mhollands/EOGee/EOGee1/Circuit_Analysis/Noise_Measurements/IMG_5777.JPG

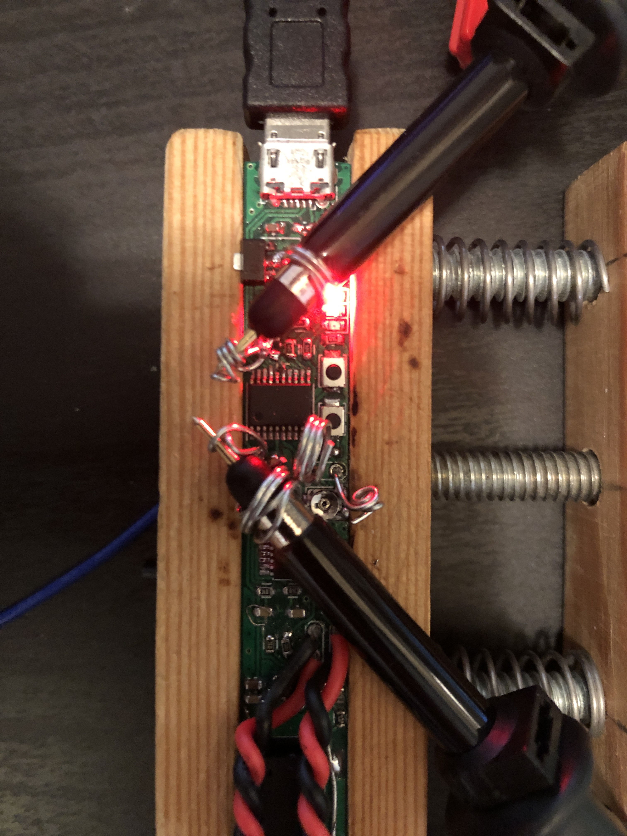
EOGee1/Circuit_Analysis/Noise_Measurements/IMG_5777.JPG
