mhollands/EOGee/README.md

# EOGee
PCB and code for capturing electrooculograms (EOG).
