mhollands/EOGee/EOGee1/Circuit_Analysis/Scope_Shots/AC_Couple/SCR09.PNG

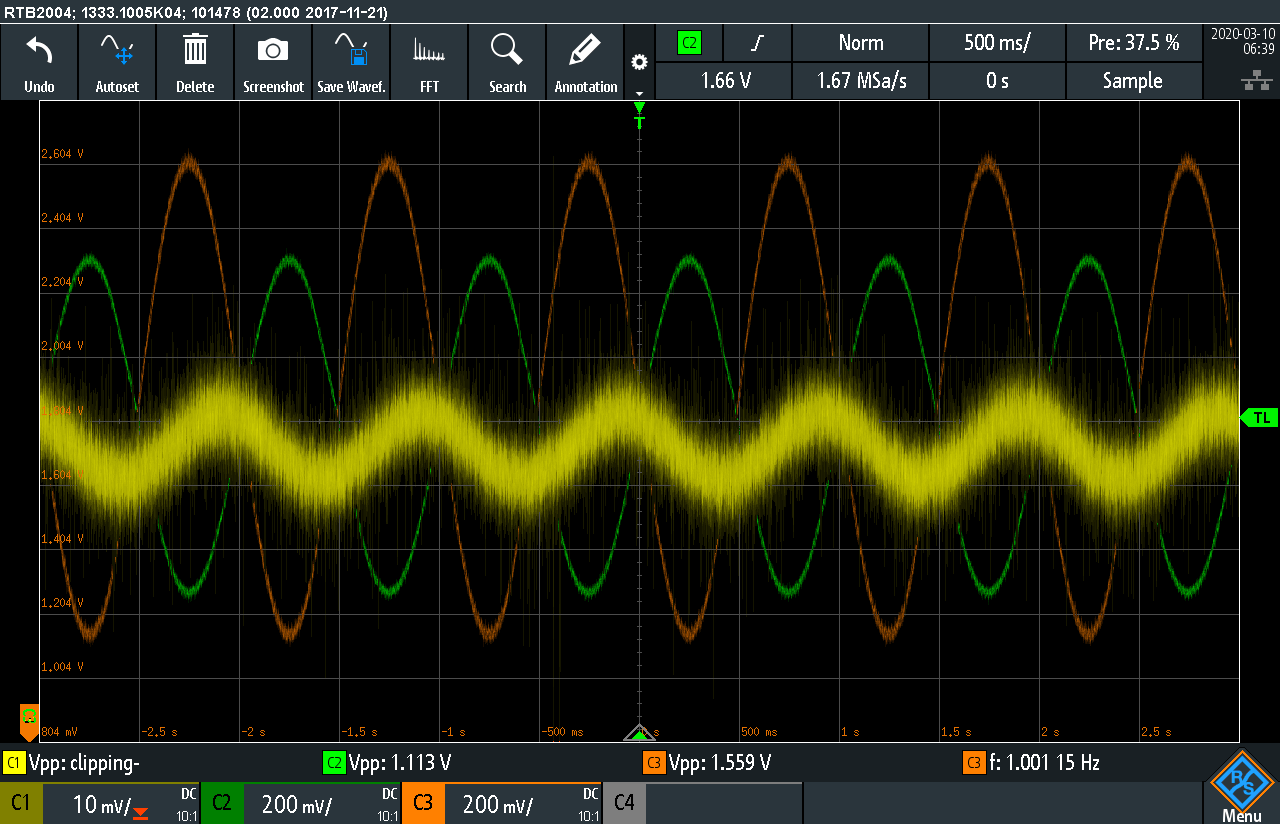
EOGee1/Circuit_Analysis/Scope_Shots/AC_Couple/SCR09.PNG
