mhollands/EOGee/Models/Glasses/EOGlass1/Media/back_view.png

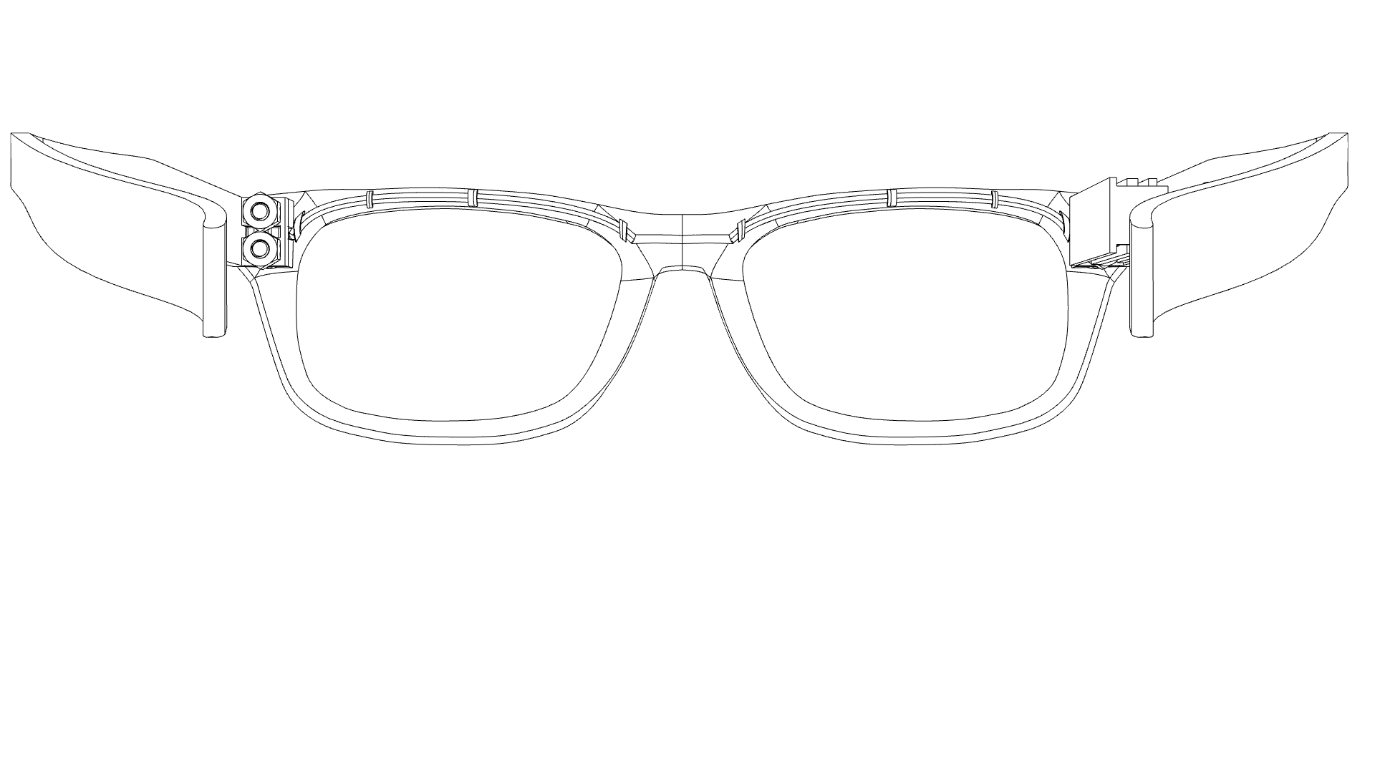
Models/Glasses/EOGlass1/Media/back_view.png
