mhollands/EOGee/Models/Glasses/EOGlass1/Media/Front_view.png

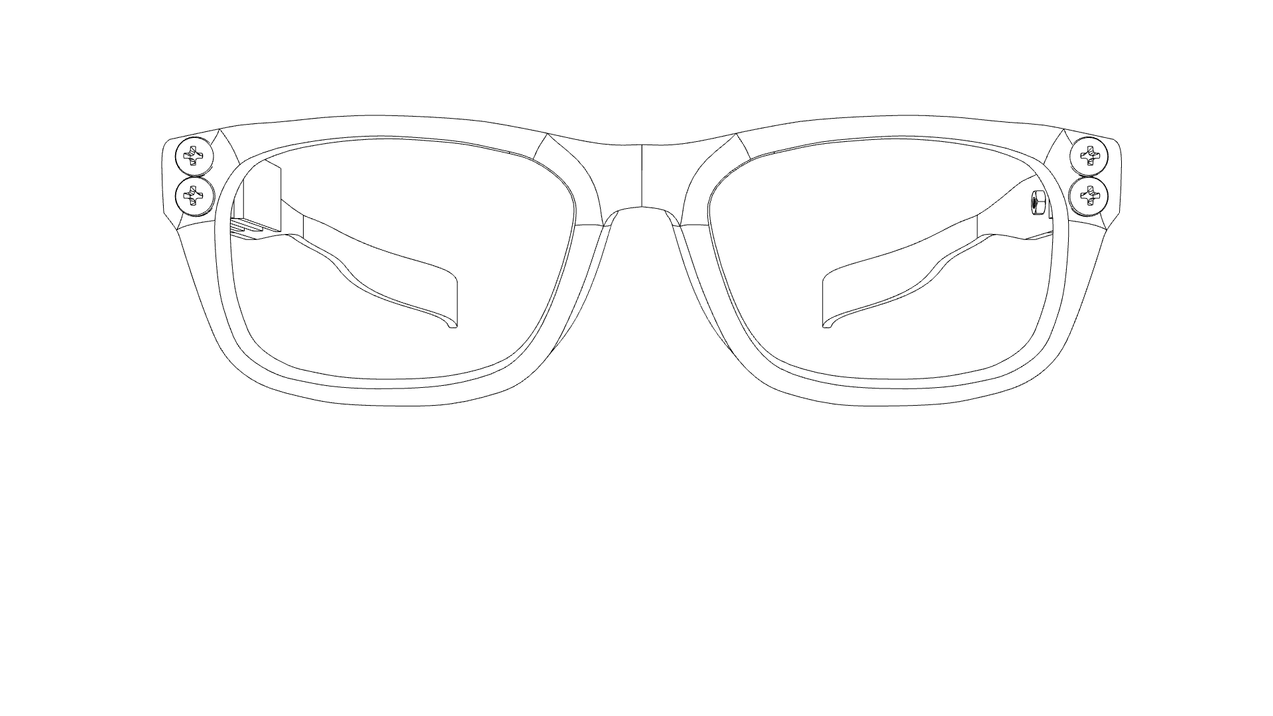
Models/Glasses/EOGlass1/Media/Front_view.png
