mhollands/EOGee/Models/Glasses/EOGlass1/Media/home_view.png

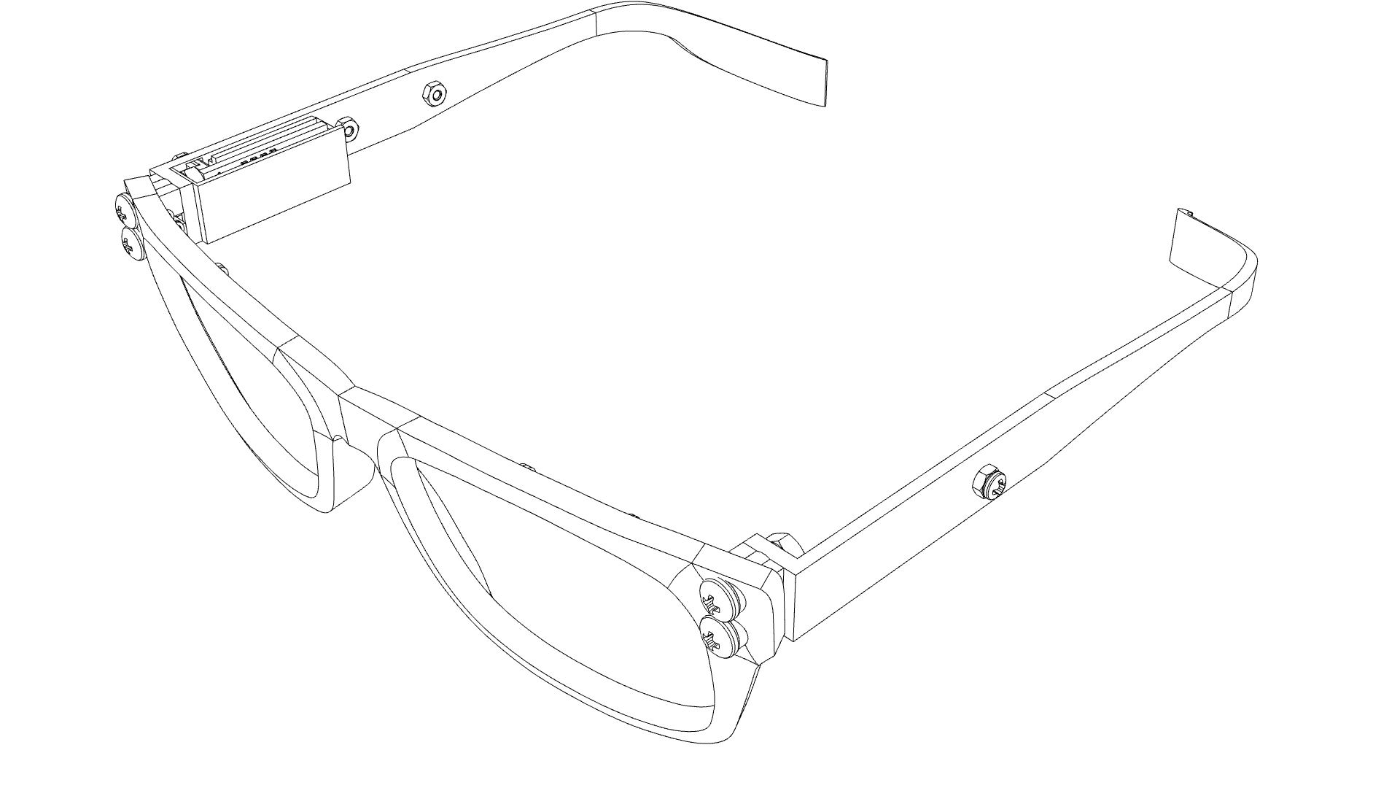
Models/Glasses/EOGlass1/Media/home_view.png
