mhollands/EOGee/Models/Glasses/EOGlass1/Media/LeftArmExploded.png

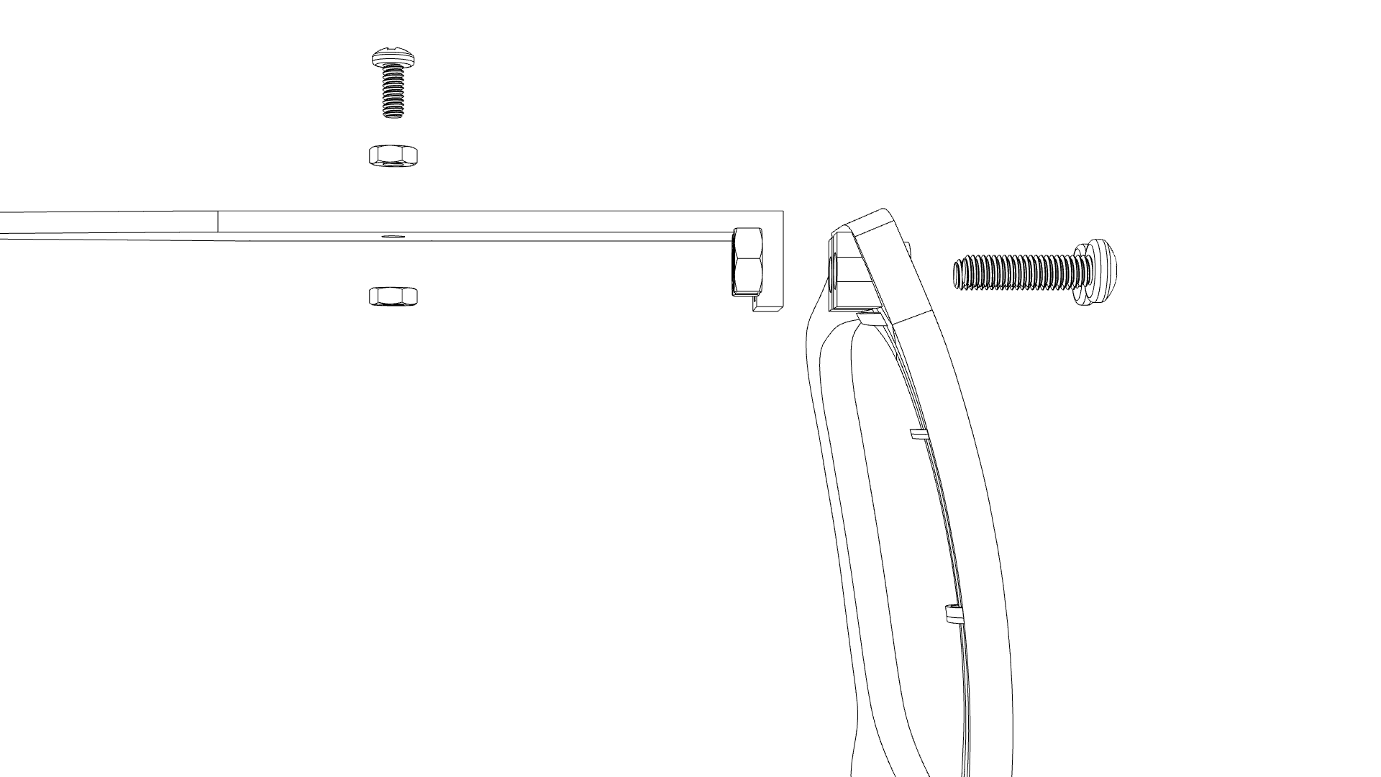
Models/Glasses/EOGlass1/Media/LeftArmExploded.png
