mhollands/EOGee/Models/Glasses/EOGlass1/Media/render 2.GIF

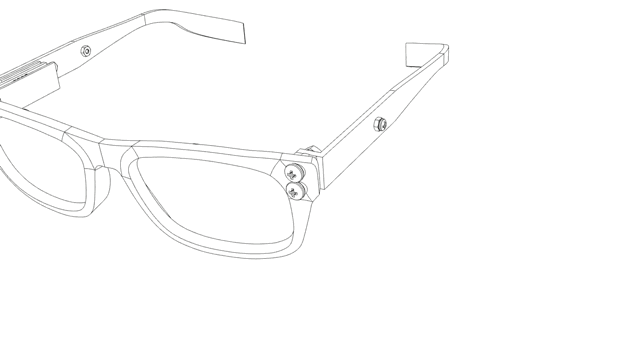
Models/Glasses/EOGlass1/Media/render 2.GIF
