mhollands/EOGee/Models/Glasses/EOGlass1/Media/render 3.GIF

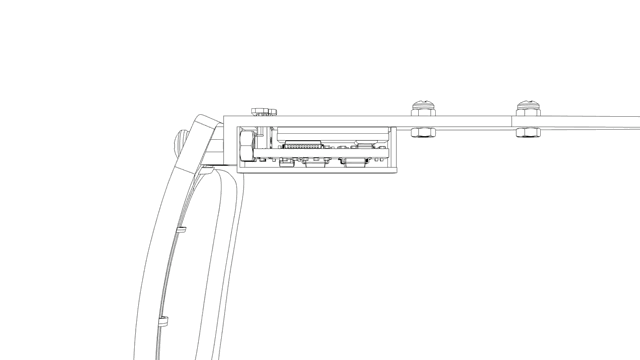
Models/Glasses/EOGlass1/Media/render 3.GIF
