mhollands/EOGee/Models/Glasses/EOGlass1/Media/render.GIF

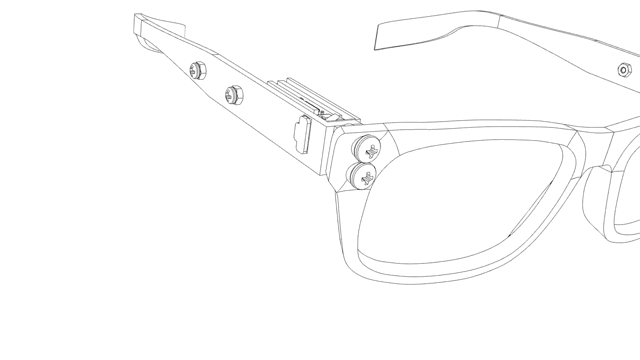
Models/Glasses/EOGlass1/Media/render.GIF
