mhollands/EOGee/Models/Glasses/EOGlass1/Media/Right_arm_exploded.png

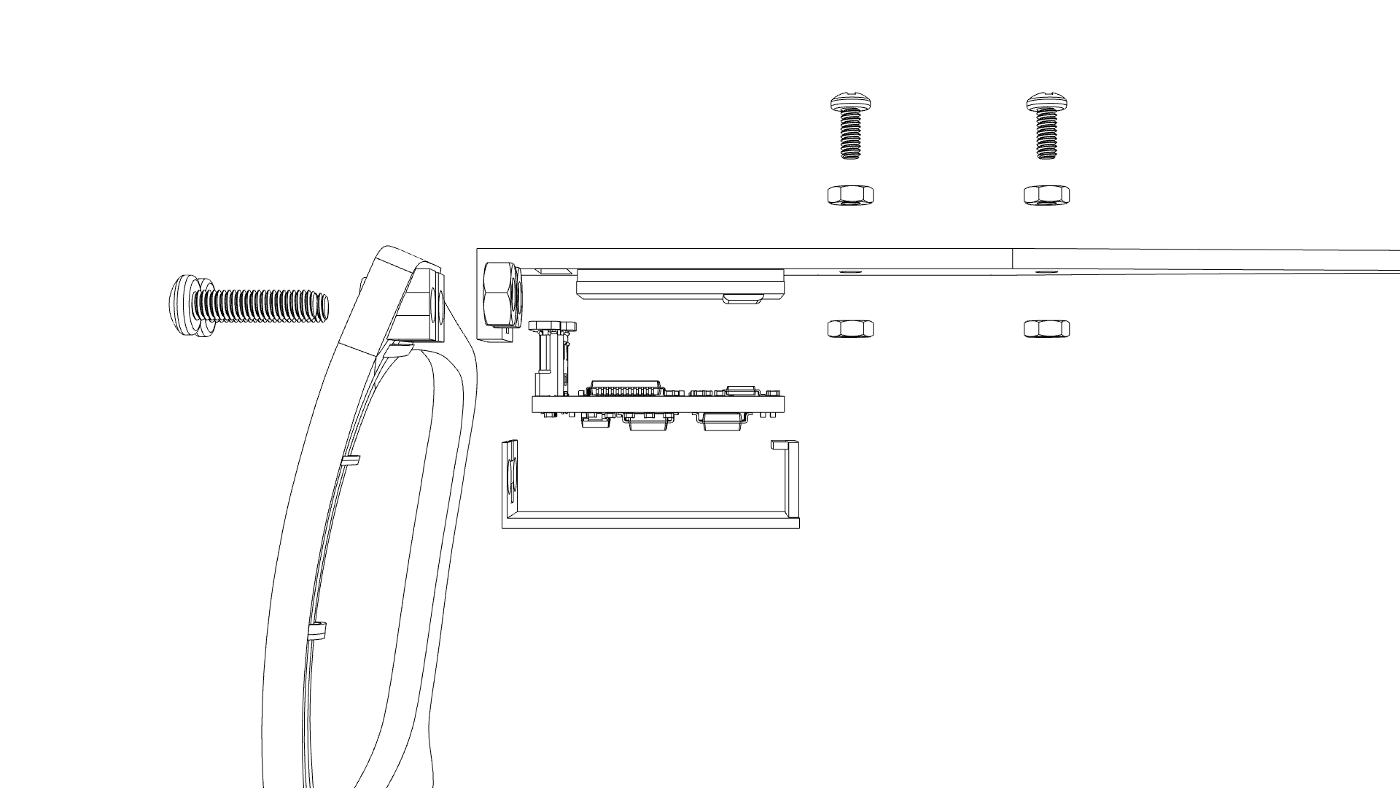
Models/Glasses/EOGlass1/Media/Right_arm_exploded.png
