mhollands/EOGee/Models/Glasses/EOGlass1/Media/Wire_channels.png

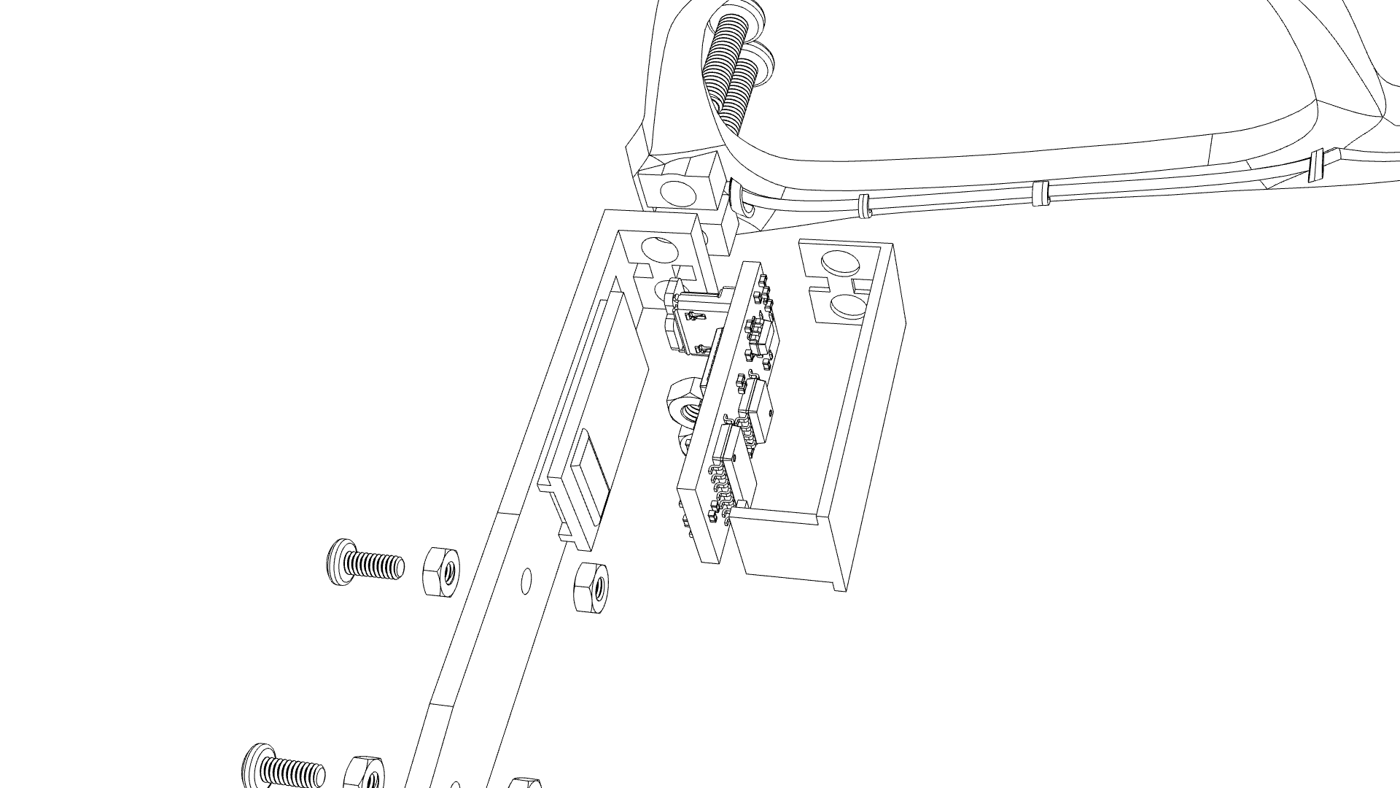
Models/Glasses/EOGlass1/Media/Wire_channels.png
