mhollands/EOGee/EOGee2/Models/clip.stl

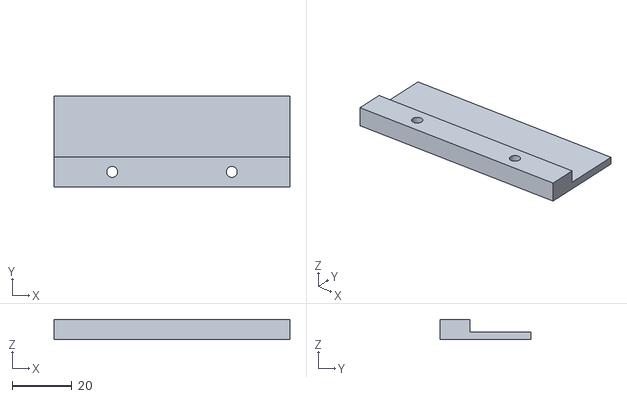
[picture p16: CAD file, 2020-05-25]
EOGee2/Models/clip.stl
79.0 x 30.4 x 6.70
