mhollands/EOGee/EOGlass1/EOGlass v1.stl

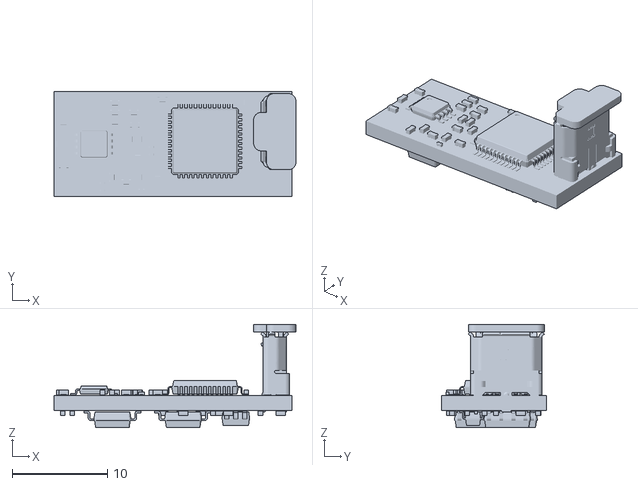
[picture p17: CAD file, 2020-06-01]
EOGlass1/EOGlass v1.stl
25.4 x 11.0 x 10.9
