mhollands/EOGee/EOGlass1/Models/arm2_contact_hooked_right2 v6.stl

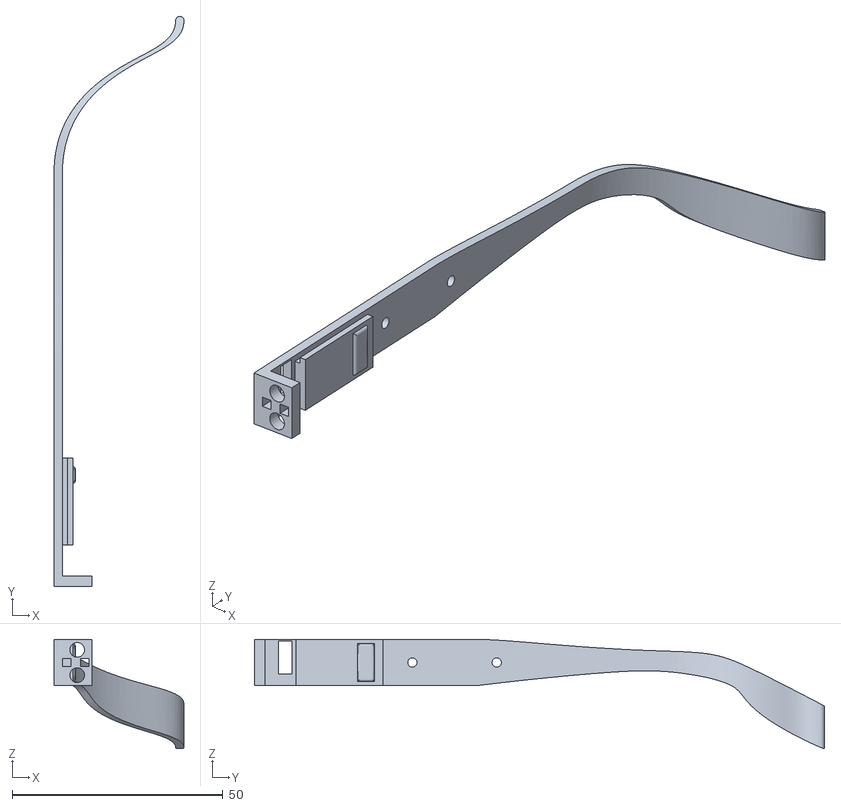
[picture p18: CAD file, 2020-06-01]
EOGlass1/Models/arm2_contact_hooked_right2 v6.stl
30.8 x 135.3 x 25.9
