mhollands/EOGee/Models/Glasses/OpenSCAD/Plastic_snap.stl

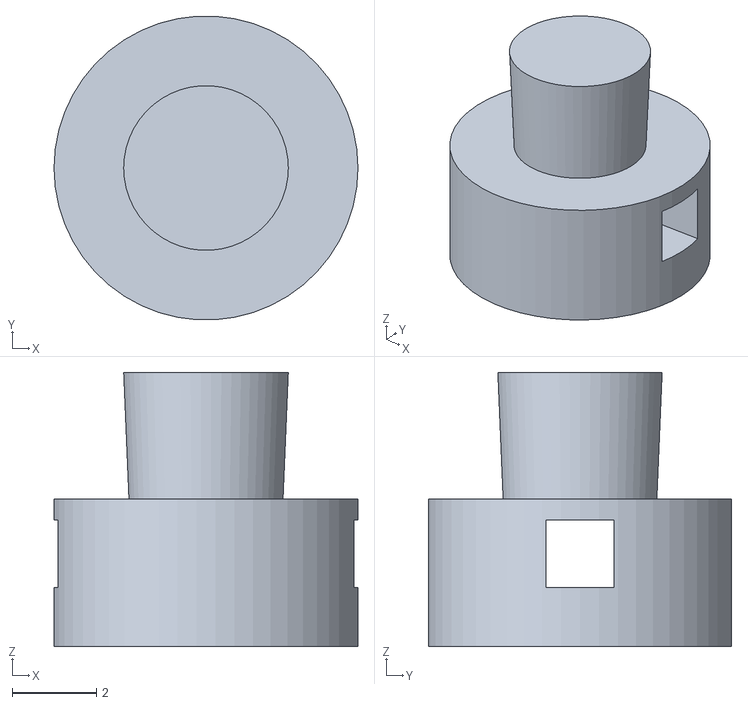
[picture p19: CAD file, 2020-03-28]
Models/Glasses/OpenSCAD/Plastic_snap.stl
7.20 x 7.19 x 6.50
