mhollands/EOGee/SigGenAdapter/Housing/Base.stl

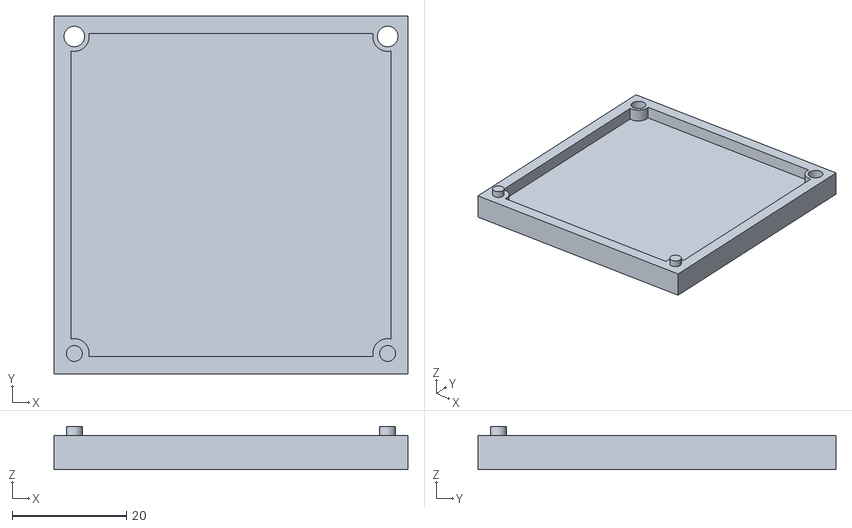
[picture p20: CAD file, 2020-03-22]
SigGenAdapter/Housing/Base.stl
62.0 x 62.6 x 7.60
