mhollands/EOGee/EOGee2/Models/Base_clip.stl

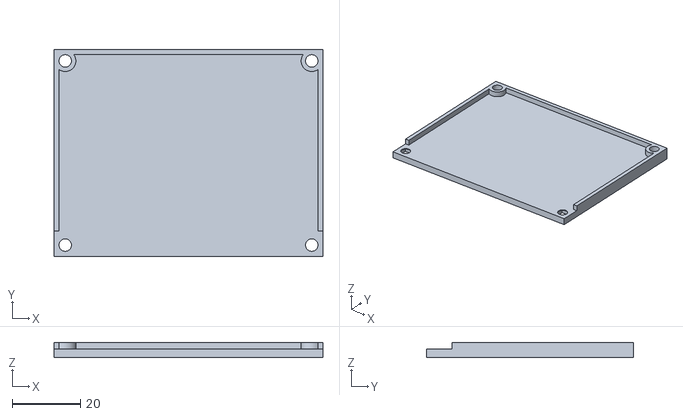
[picture p21: CAD file, 2020-05-25]
EOGee2/Models/Base_clip.stl
79.0 x 60.7 x 4.50
