mhollands/EOGee/EOGlass1/Models/PCB_Cover v12.stl

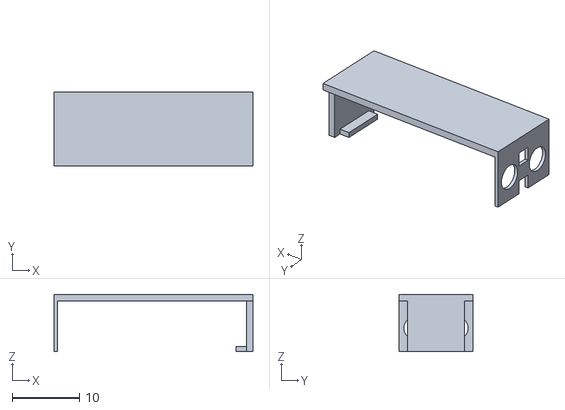
[picture p22: CAD file, 2020-06-01]
EOGlass1/Models/PCB_Cover v12.stl
29.5 x 11.0 x 8.50
