mhollands/EOGee/Models/Glasses/OpenSCAD/Glasses_front.stl

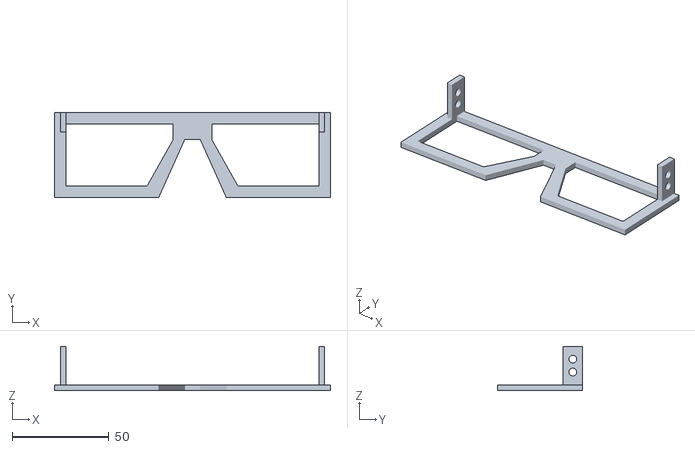
[picture p23: CAD file, 2020-02-24]
Models/Glasses/OpenSCAD/Glasses_front.stl
143.0 x 44.0 x 23.0
