mhollands/EOGee/SigGenAdapter/Housing/Lid.stl

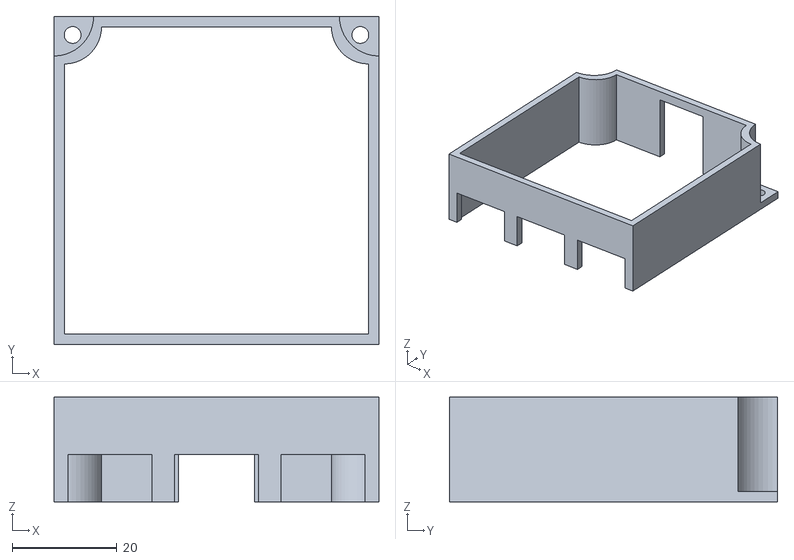
[picture p24: CAD file, 2020-03-22]
SigGenAdapter/Housing/Lid.stl
62.0 x 62.6 x 20.0
