mhollands/EOGee/EOGee2/Models/Base.stl

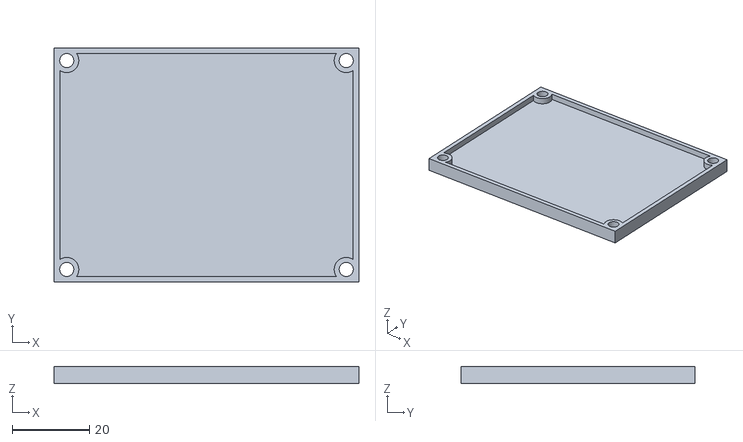
[picture p25: CAD file, 2020-04-12]
EOGee2/Models/Base.stl
79.0 x 60.7 x 4.50
