mhollands/EOGee/EOGlass1/Models/arm2_contact_hooked_LEFT v2.stl

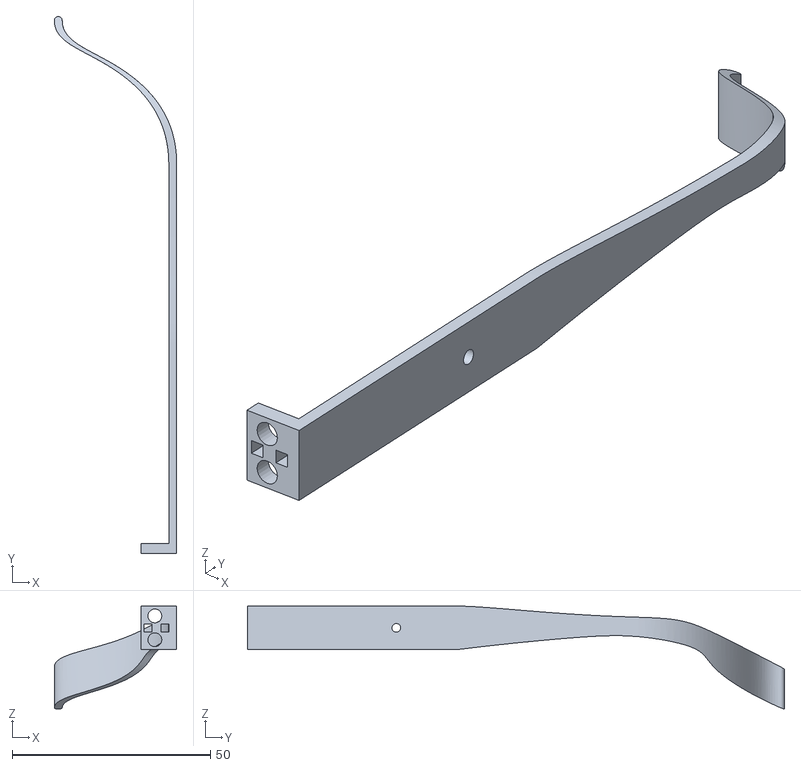
[picture p26: CAD file, 2020-06-01]
EOGlass1/Models/arm2_contact_hooked_LEFT v2.stl
30.8 x 135.3 x 25.9
