mhollands/EOGee/Models/Glasses/OpenSCAD/Glasses_front_right.stl

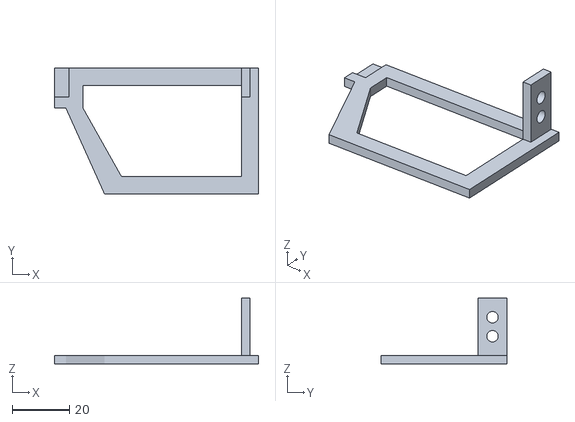
[picture p27: CAD file, 2020-02-24]
Models/Glasses/OpenSCAD/Glasses_front_right.stl
71.5 x 44.0 x 23.0
