mhollands/EOGee/EOGee2/Models/Housing.stl

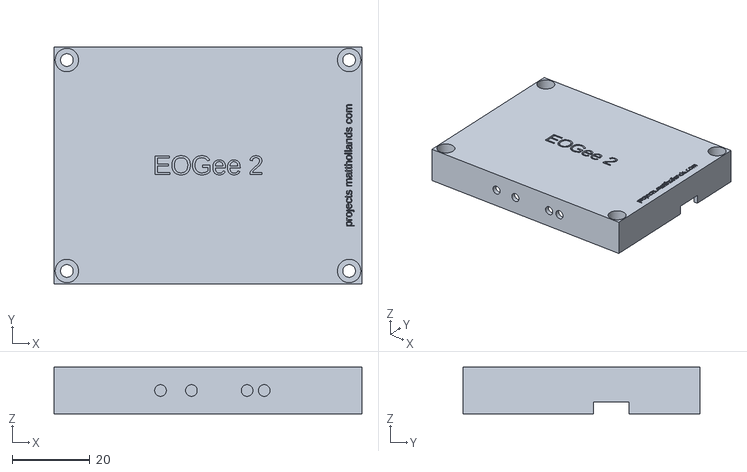
[picture p28: CAD file, 2020-04-12]
EOGee2/Models/Housing.stl
79.0 x 60.7 x 12.0
