mhollands/EOGee/EOGlass1/Models/Glasses2_integrated v3.stl

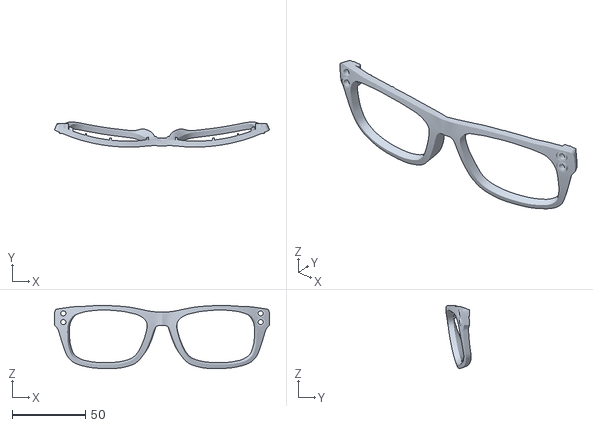
[picture p29: CAD file, 2020-06-01]
EOGlass1/Models/Glasses2_integrated v3.stl
146.9 x 17.2 x 43.1
