mhollands/EOGee/(list of files, cad)

Other CAD files:
EOGee2/Models/Base_clip.scad
