mhollands/EOGee/EOGee1/Circuit_Analysis/Noise_Measurements/Data_streamed_over_spi_no_usb/BUS05.CSV

Bus Table: B1 (SPI (no CS): 8 Bit, MSB, Clk = C1, Data = C2)
Frame | Mark | Time Diff. in s | Length | Data | State
1 |  | 12.52844800e-3 | 20 | 0xB407B507B507B407B407B407B407B307B407B407 | OK
2 |  | 13.65203200e-3 | 20 | 0xB307B307B407B407B407B307B507B407B407B307 | OK
3 |  | 13.65324800e-3 | 20 | 0xB407B507B407B507B307B407B507B407B407B307 | OK
4 |  | 13.65324800e-3 | 20 | 0xB407B407B407B307B407B407B407B307B407B407 | OK
5 |  | 13.65203200e-3 | 20 | 0xB407B307B307B407B407B507B407B407B407B407 | OK
6 |  | 13.65446400e-3 | 20 | 0xB407B407B407B407B407B307B407B407B507B407 | OK
7 |  | 13.65324800e-3 | 20 | 0xB307B407B307B407B407B407B407B307B407B307 | OK
8 |  | 13.65324800e-3 | 20 | 0xB407B307B407B407B207B407B407B507B407B407 | OK
9 |  | 13.65203200e-3 | 20 | 0xB407B407B407B407B407B407B407B407B307B507 | OK
10 |  | 13.65324800e-3 | 20 | 0xB407B207B407B207B407B507B507B507B407B307 | OK
11 |  | 13.65081600e-3 | 20 | 0xB407B407B407B407B407B407B307B307B407B507 | OK
12 |  | 13.65324800e-3 | 20 | 0xB407B407B307B407B307B407B307B407B407B407 | OK
13 |  | 13.65324800e-3 | 20 | 0xB307B407B407B307B407B407B407B207B407B407 | OK
14 |  | 13.65324800e-3 | 20 | 0xB307B307B307B307B307B307B407B507B407B307 | OK
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
