mhollands/EOGee/EOGee1/Circuit_Analysis/Noise_Measurements/Data_streamed_over_spi_no_usb/BUS06.CSV

Bus Table: B1 (SPI (no CS): 8 Bit, MSB, Clk = C1, Data = C2)
Frame | Mark | Time Diff. in s | Length | Data | State
1 |  | 12.50169600e-3 | 20 | 0xB307B407B307B307B407B307B407B507B407B407 | OK
2 |  | 13.65568000e-3 | 20 | 0xB307B407B307B407B407B307B307B407B307B407 | OK
3 |  | 13.65568000e-3 | 20 | 0xB407B407B307B307B407B407B407B407B307B307 | OK
4 |  | 13.65568000e-3 | 20 | 0xB407B307B507B207B507B207B307B407B307B407 | OK
5 |  | 13.65446400e-3 | 20 | 0xB407B407B407B507B307B407B407B407B407B407 | OK
6 |  | 13.65568000e-3 | 20 | 0xB307B307B307B407B207B407B307B307B307B307 | OK
7 |  | 13.65568000e-3 | 20 | 0xB407B407B307B407B307B307B407B407B407B407 | OK
8 |  | 13.65689600e-3 | 20 | 0xB407B307B407B507B407B507B307B407B407B307 | OK
9 |  | 13.65689600e-3 | 20 | 0xB307B307B407B307B307B507B407B407B307B407 | OK
10 |  | 13.65568000e-3 | 20 | 0xB207B407B307B307B307B407B407B307B407B407 | OK
11 |  | 13.65689600e-3 | 20 | 0xB307B307B407B407B407B307B307B407B307B407 | OK
12 |  | 13.65446400e-3 | 20 | 0xB407B407B407B207B507B407B407B307B207B407 | OK
13 |  | 13.65568000e-3 | 20 | 0xB407B207B407B307B307B407B407B407B407B307 | OK
14 |  | 13.65568000e-3 | 20 | 0xB207B407B207B307B407B407B207B307B307B407 | OK
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
