mhollands/EOGee/EOGee1/Circuit_Analysis/Noise_Measurements/ADC_GULP.PNG

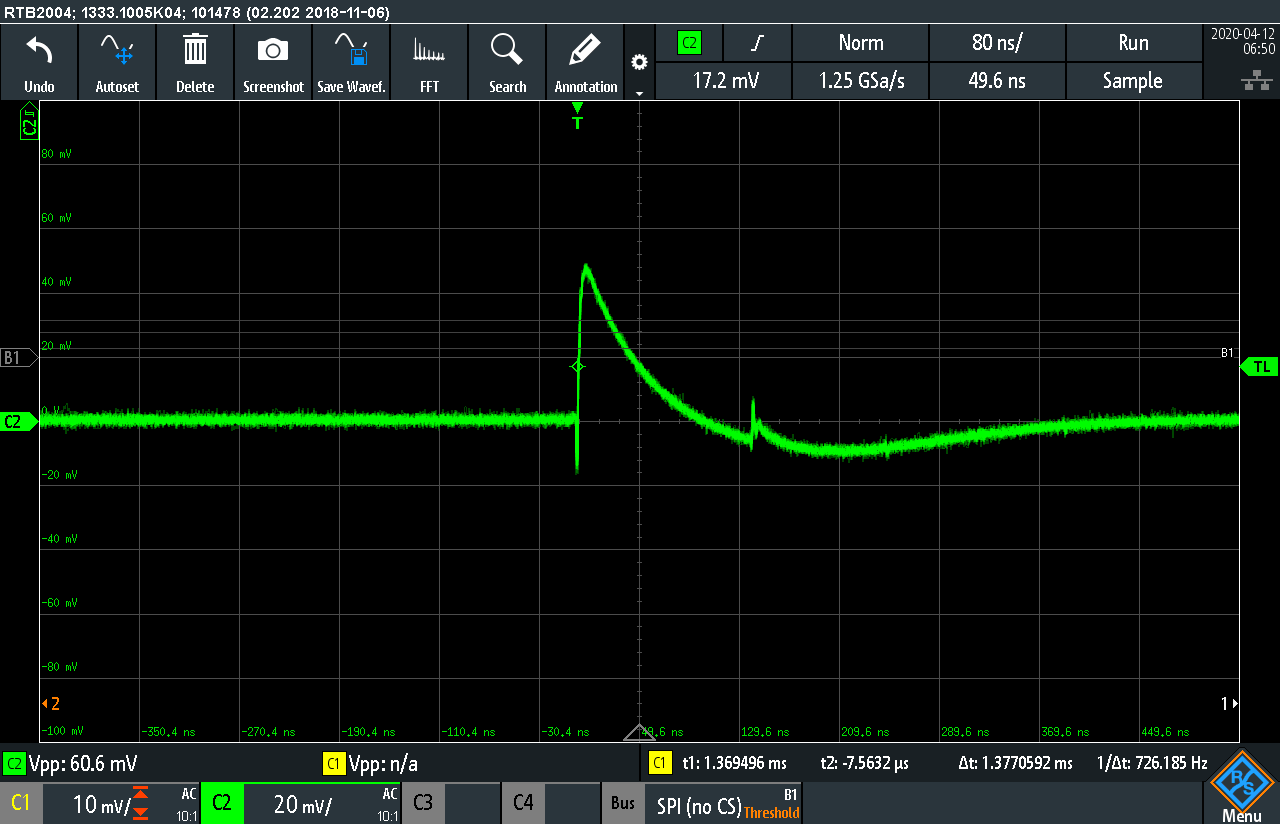
EOGee1/Circuit_Analysis/Noise_Measurements/ADC_GULP.PNG
