mhollands/EOGee/EOGee1/Circuit_Analysis/Noise_Measurements/AVDD_USB_OFF.PNG

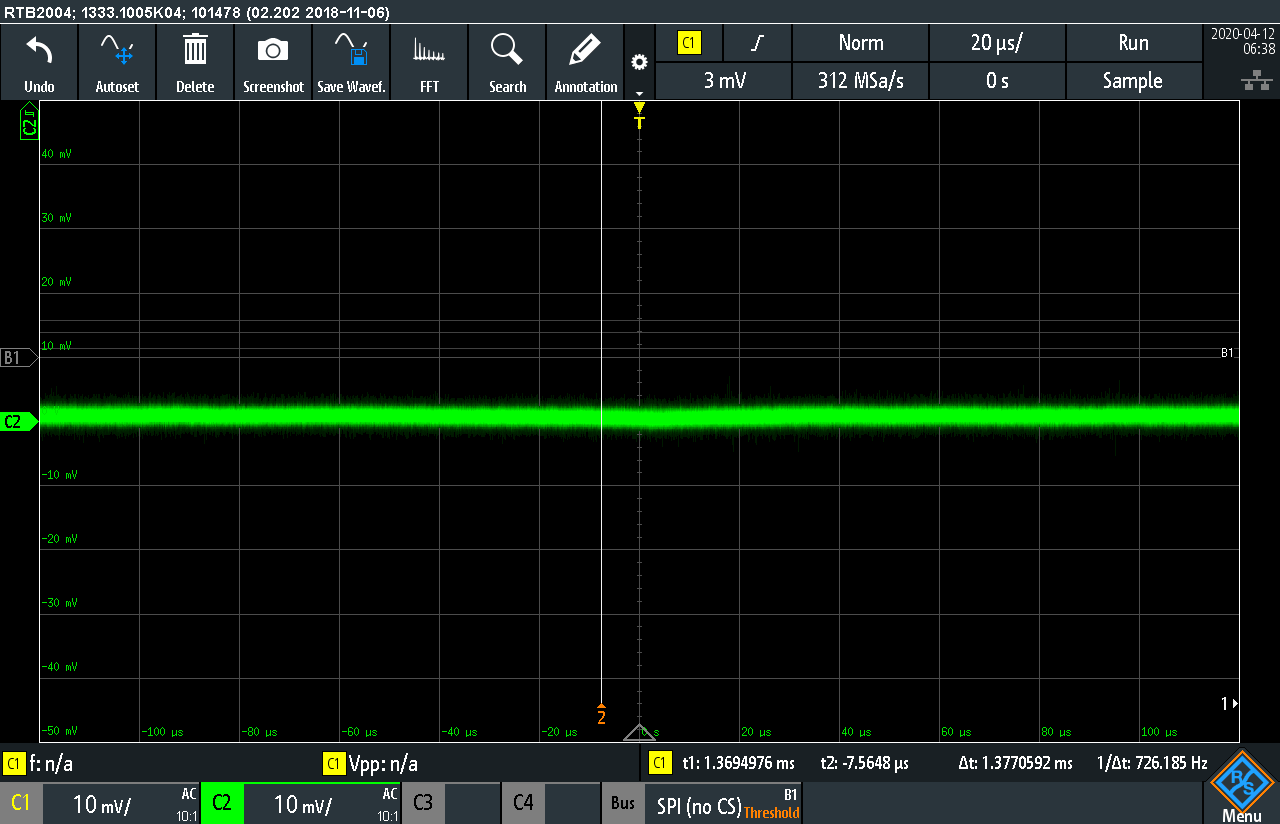
EOGee1/Circuit_Analysis/Noise_Measurements/AVDD_USB_OFF.PNG
