mhollands/EOGee/EOGee1/Circuit_Analysis/Noise_Measurements/AVDD_USB_ON.PNG

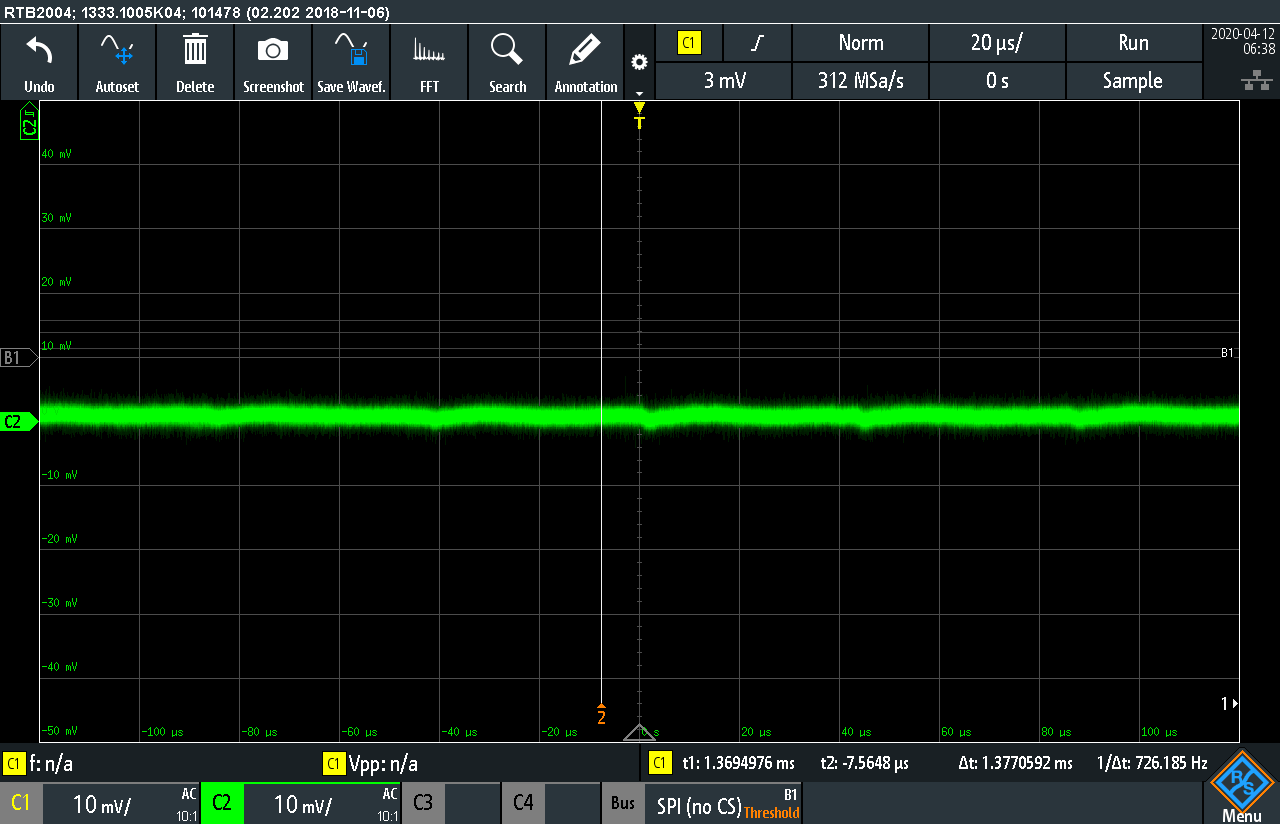
EOGee1/Circuit_Analysis/Noise_Measurements/AVDD_USB_ON.PNG
