mhollands/EOGee/EOGee1/Circuit_Analysis/Noise_Measurements/Data_streamed_over_spi_no_usb/SCR48.PNG

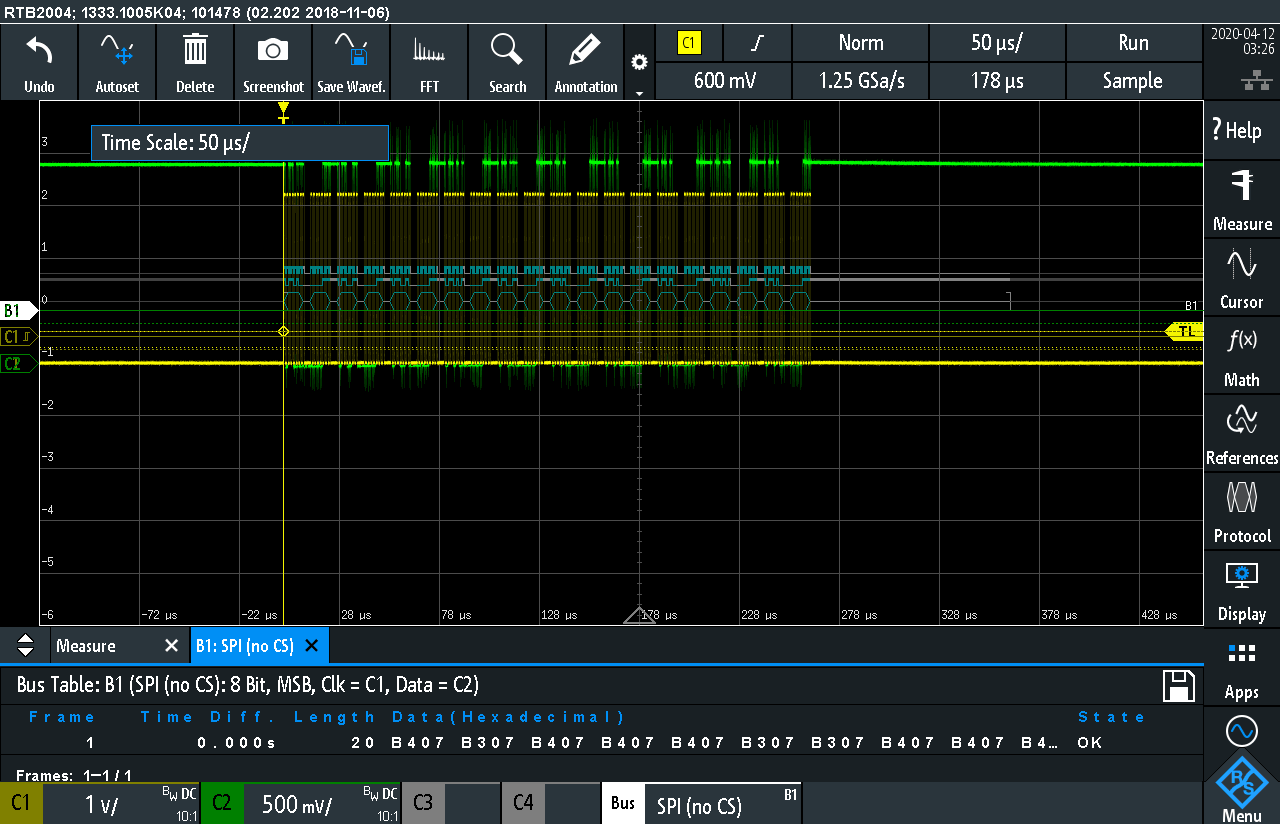
EOGee1/Circuit_Analysis/Noise_Measurements/Data_streamed_over_spi_no_usb/SCR48.PNG
