mhollands/EOGee/EOGee1/Circuit_Analysis/Noise_Measurements/DVDD_AVDD_USB_OFF.PNG

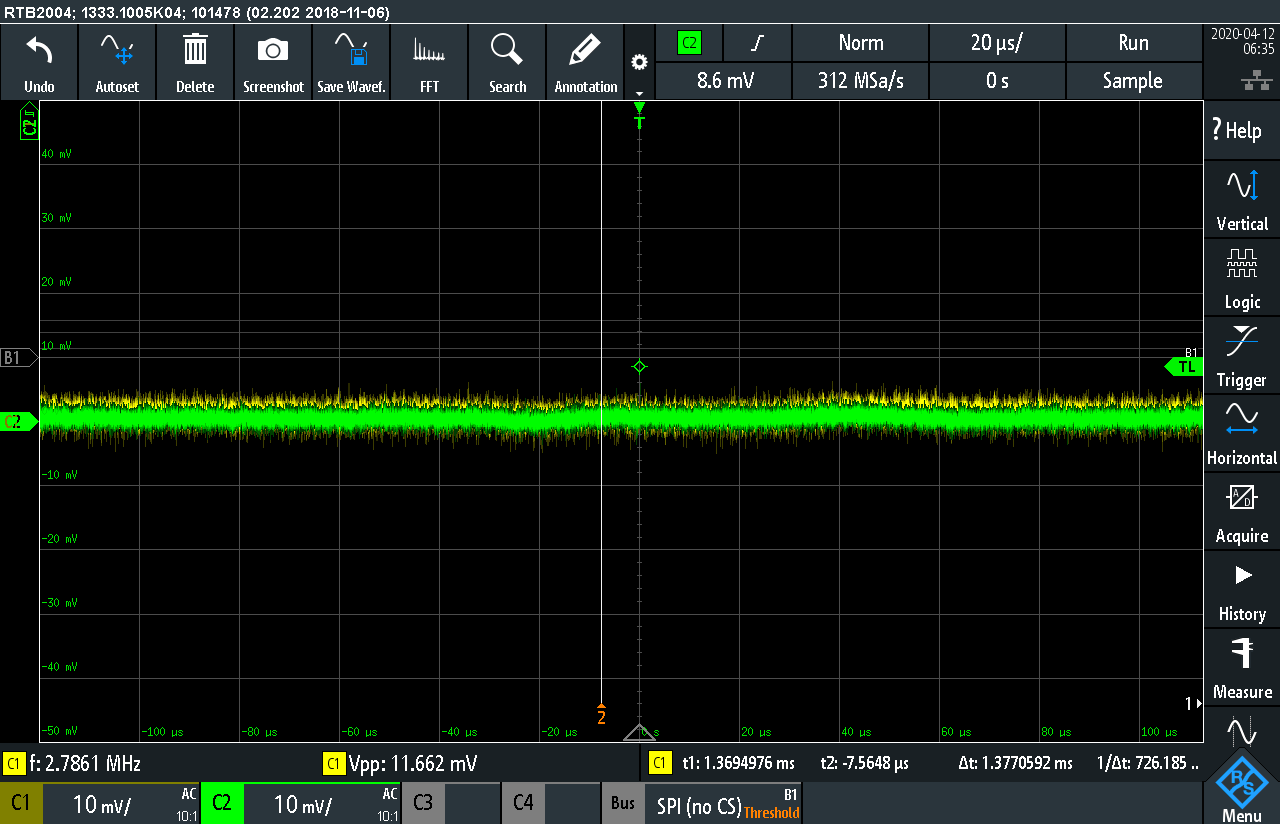
EOGee1/Circuit_Analysis/Noise_Measurements/DVDD_AVDD_USB_OFF.PNG
