mhollands/EOGee/EOGee1/Circuit_Analysis/Noise_Measurements/DVDD_AVDD_USB_ON.PNG

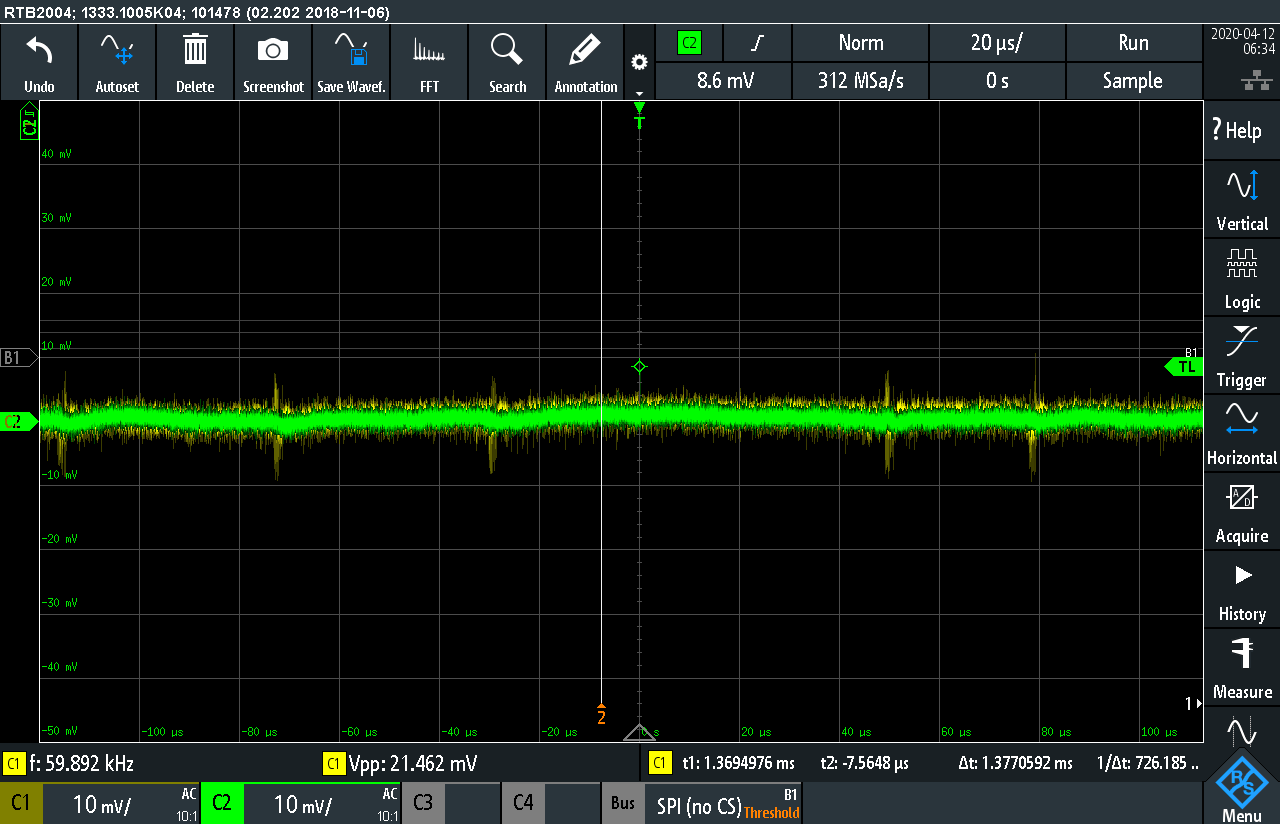
EOGee1/Circuit_Analysis/Noise_Measurements/DVDD_AVDD_USB_ON.PNG
