mhollands/EOGee/EOGee2/Circuit_Analysis/Noise_Measurements/noise_measurement_no_probe.png

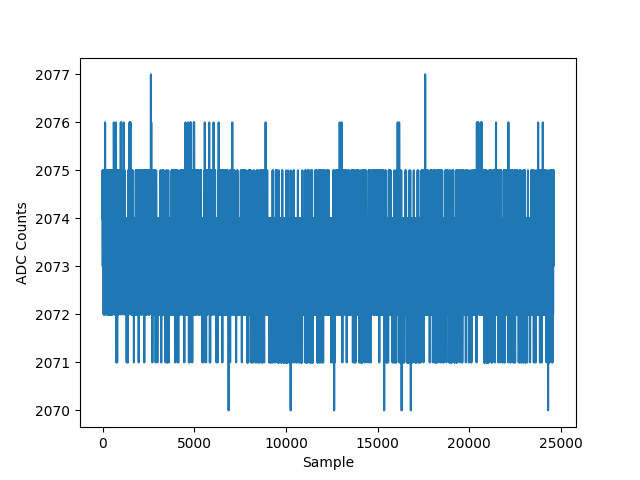
EOGee2/Circuit_Analysis/Noise_Measurements/noise_measurement_no_probe.png
