mhollands/EOGee/EOGlass1/Schematic.pdf

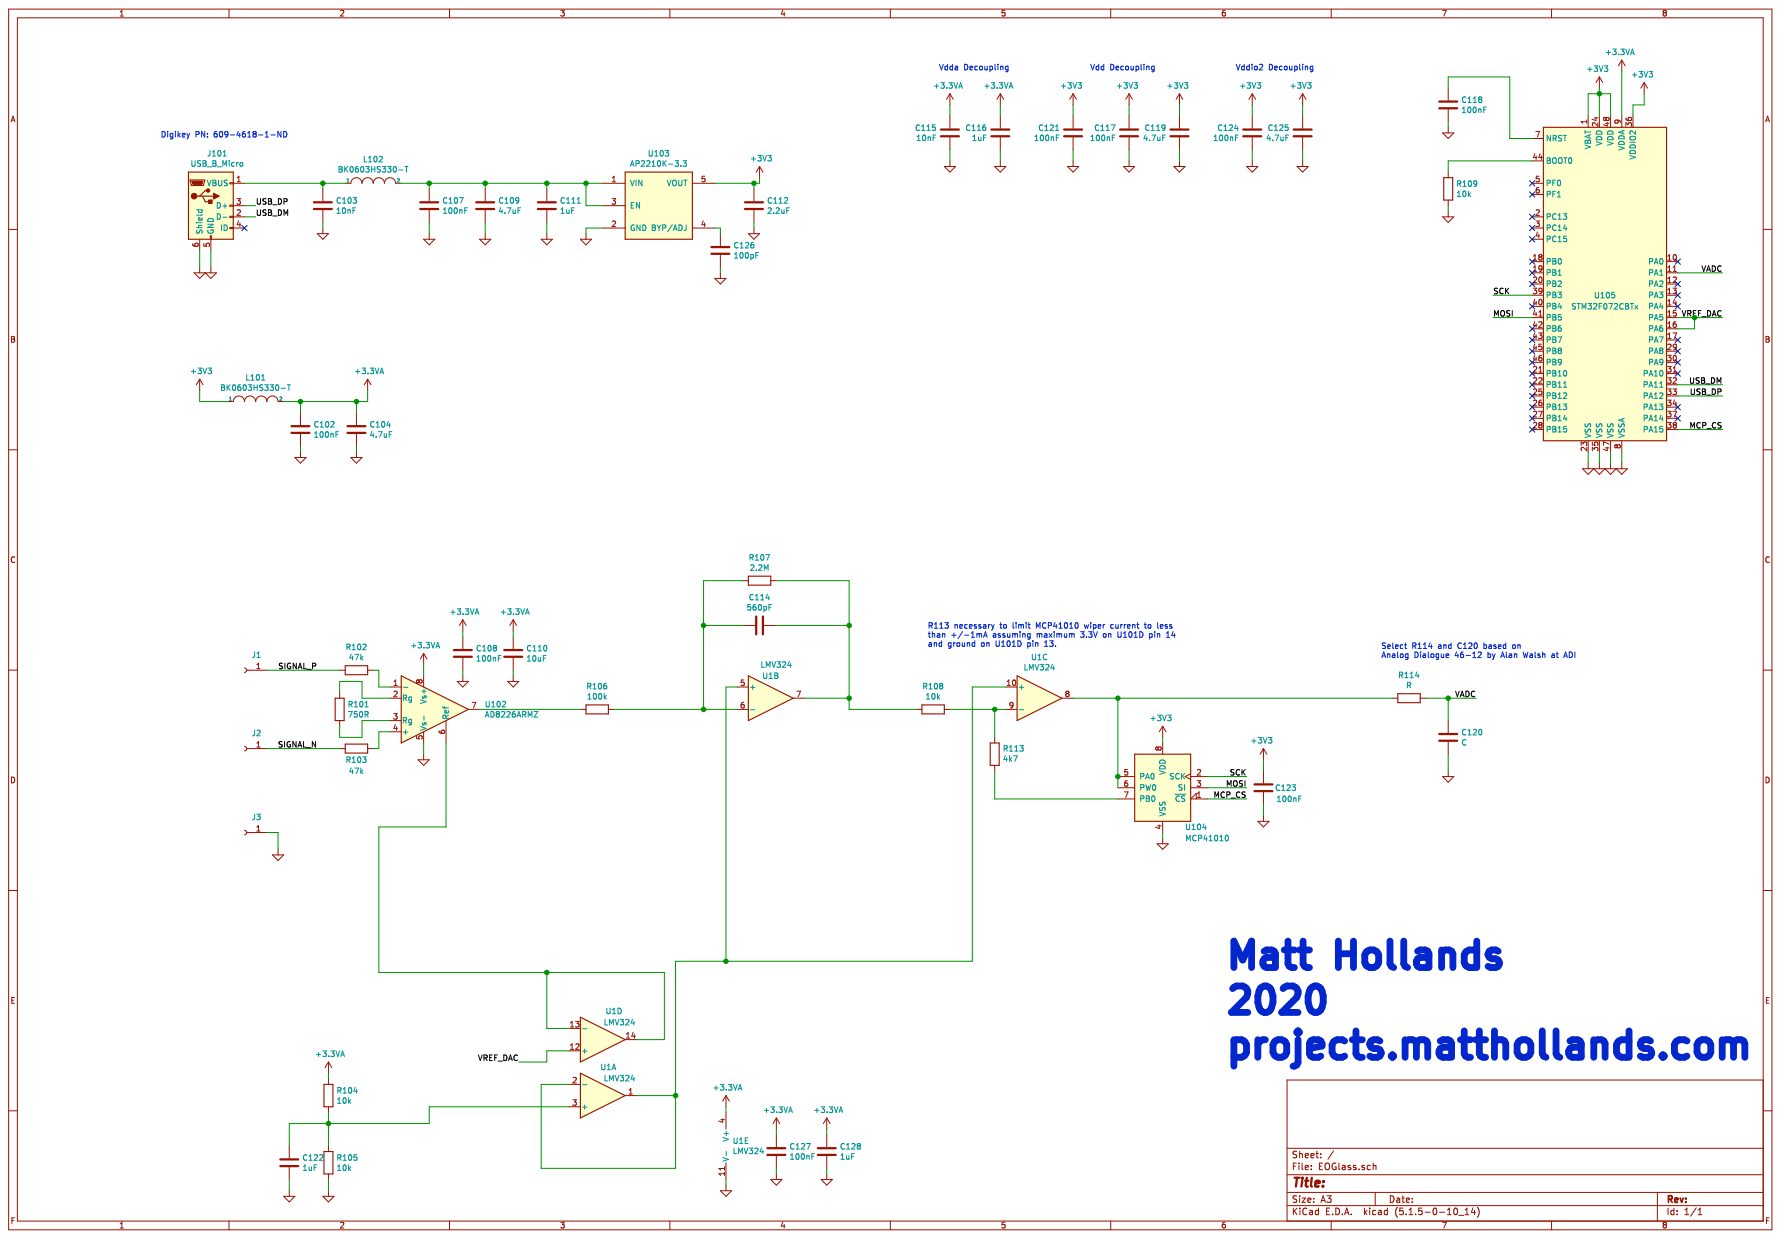
[picture p37: page 1]
