mhollands/EOGee/EOGee2/EOGee2_Schematic.pdf

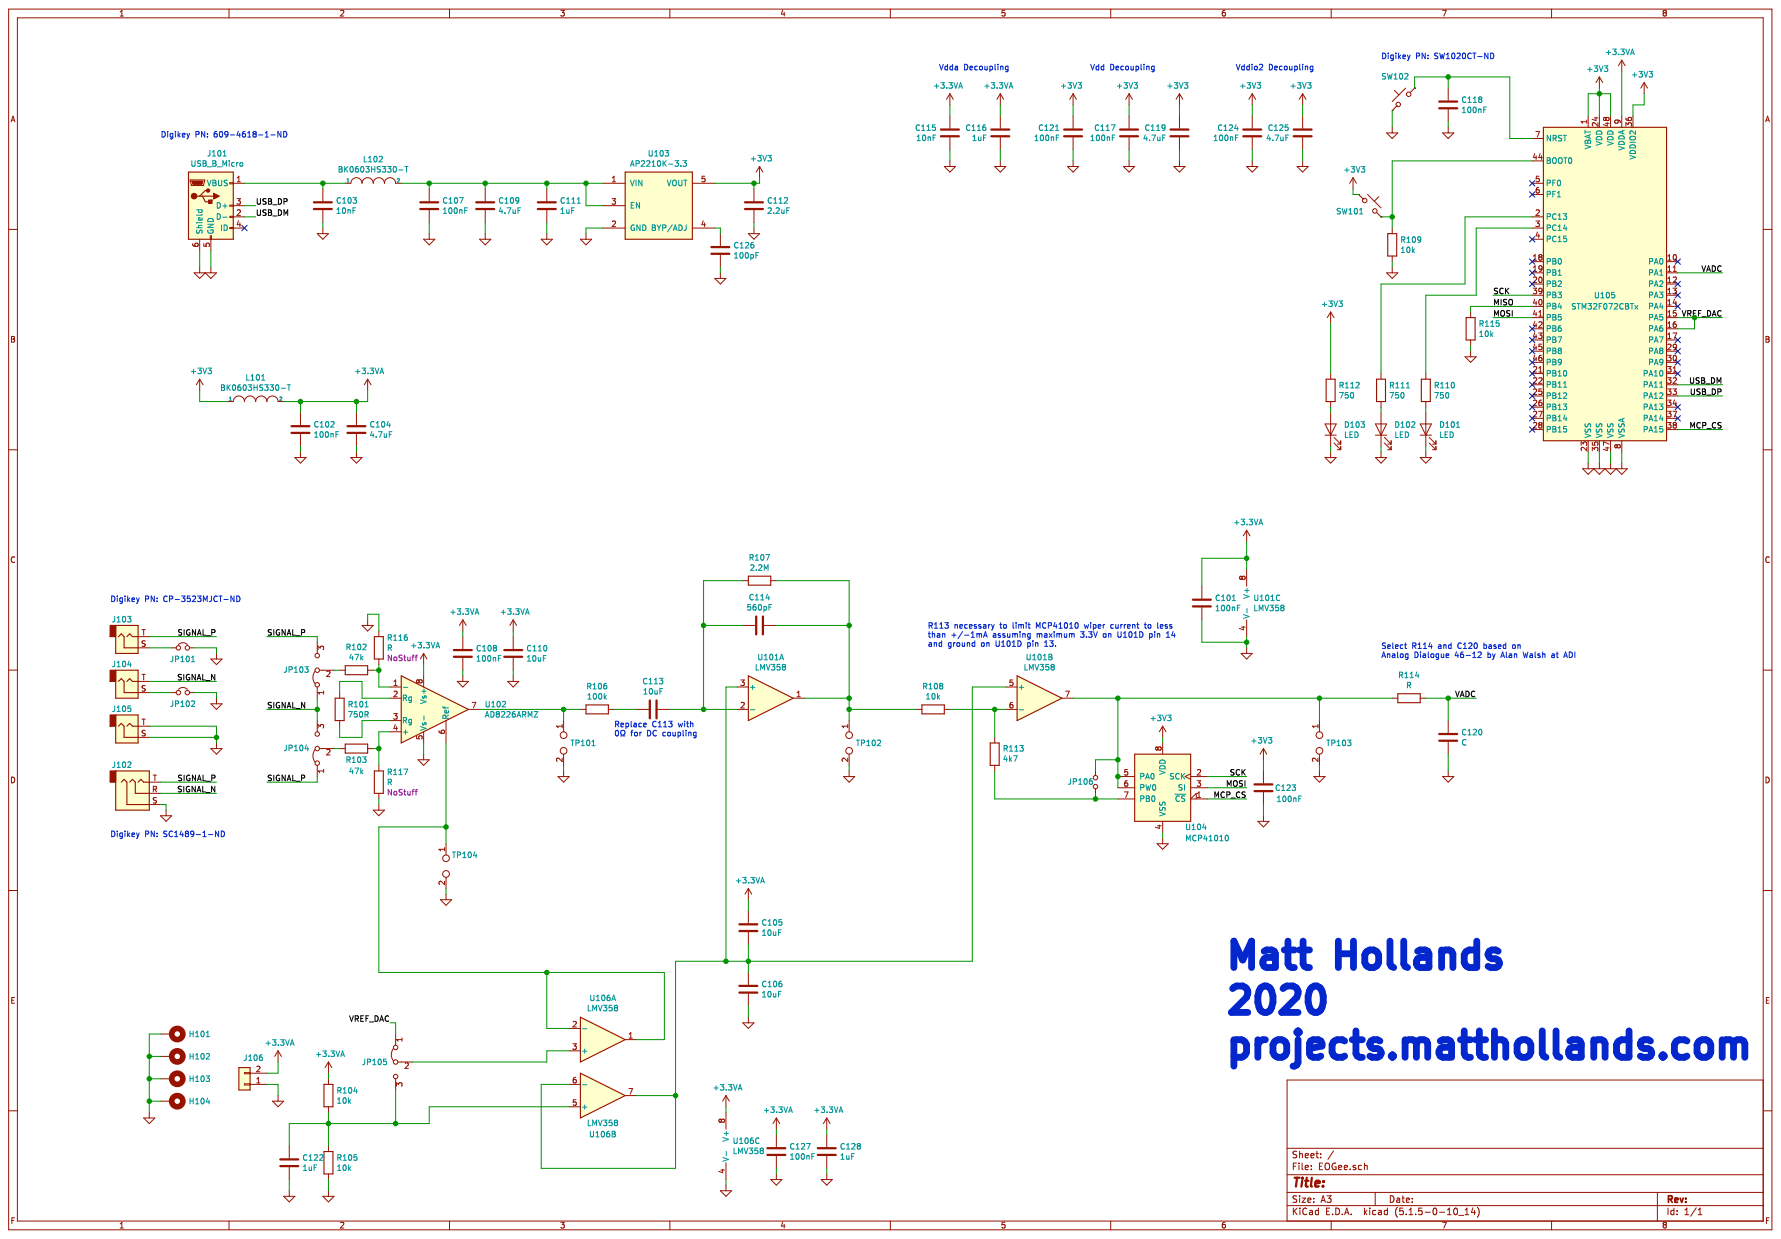
[picture p38: page 1]
