mhollands/EOGee/EOGee1/Schematic_v1.pdf

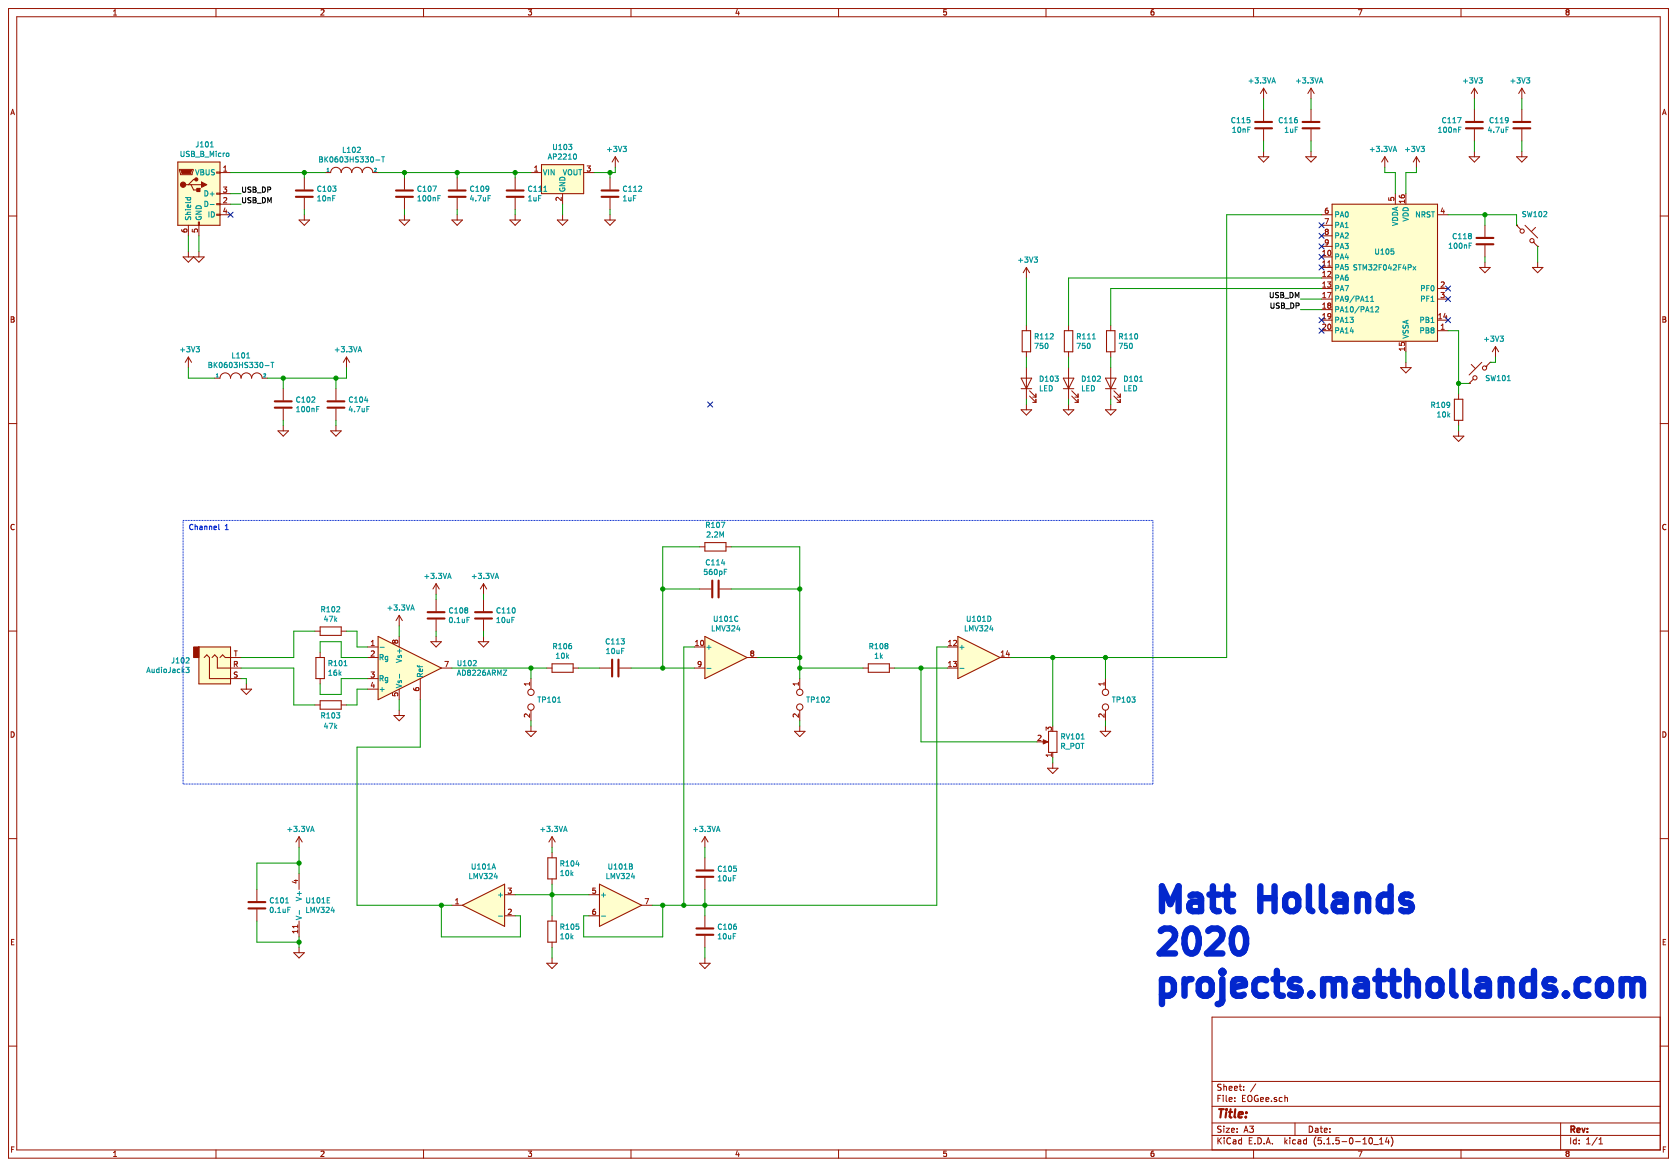
[picture p39: page 1]
