mhollands/EOGee/SigGenAdapter/PCB/SigGenAdapter/Schematic.pdf

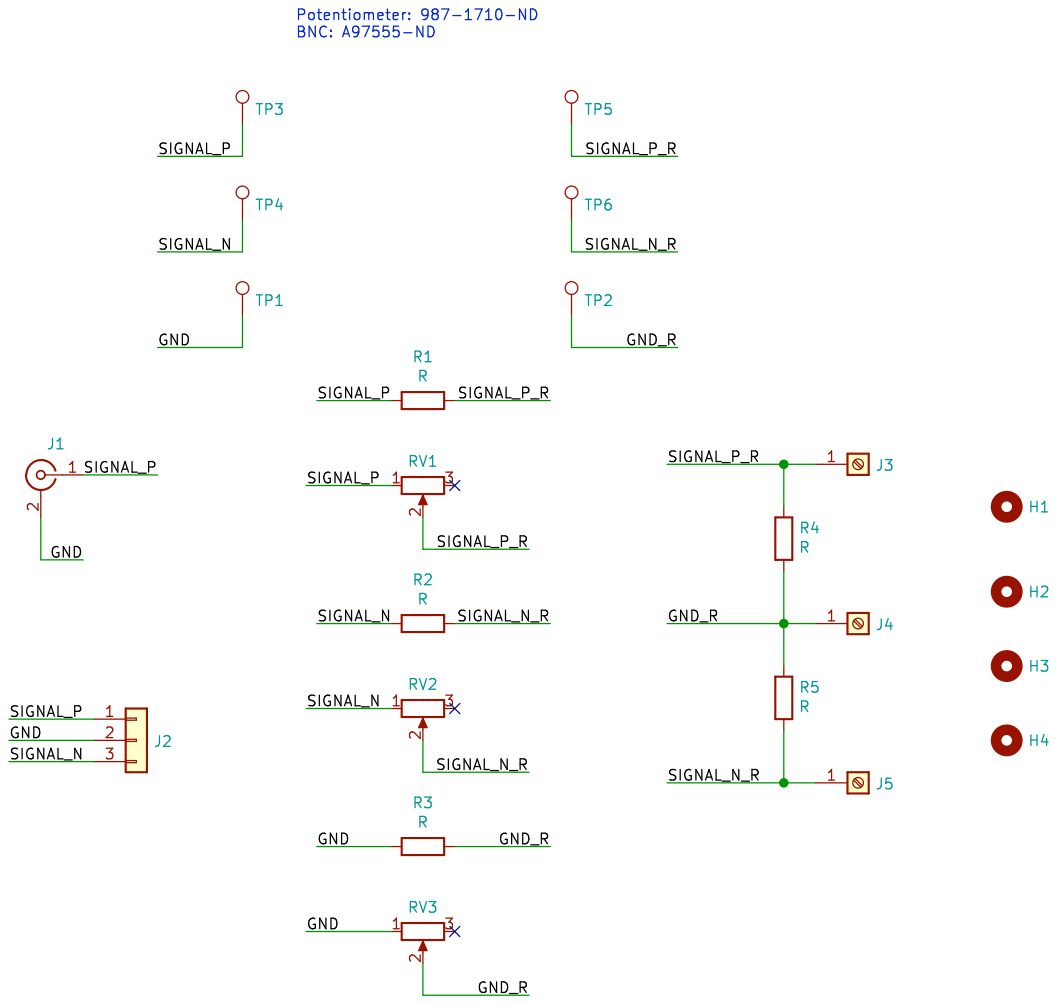
[picture p40: page 1]
