mhollands/EOGee/EOGlass1/EOGlass.kicad_pcb

## KiCad design EOGlass1/EOGlass.kicad_pcb (2020-06-01)

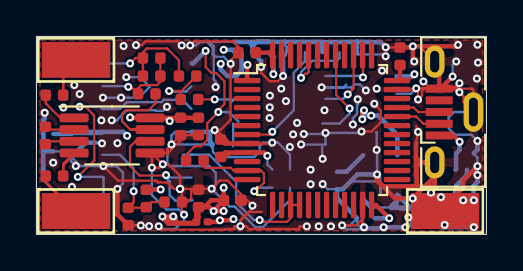
[picture p41: board EOGlass.kicad_pcb from above]

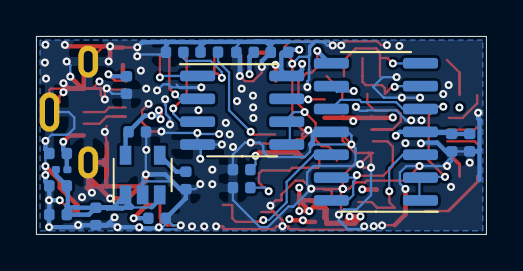
[picture p42: board EOGlass.kicad_pcb from below]

Board: 4 copper layers, 25.0 x 11.0 mm, 46 parts (20 on the bottom side), 30 nets.

Parts:
C102, C107, C108, C117, C118, C121, C123, C124, C127: 100nF; C_0402_1005Metric
C103, C115: 10nF; C_0402_1005Metric
C104, C109, C119, C125: 4.7uF; C_0402_1005Metric
C110: 10uF; C_0402_1005Metric
C111, C116, C122, C128: 1uF; C_0402_1005Metric
C112: 2.2uF; C_0402_1005Metric
C114: 560pF; C_0402_1005Metric
C120: C; C_0402_1005Metric
C126: 100pF; C_0402_1005Metric
J1, J2, J3: Conn_01x01_Female; TestPoint_Keystone_5019_Minature
J101: USB_B_Micro; USB_Micro-B_Molex-105133-0001
L101, L102: BK0603HS330-T; L_0201_0603Metric
R101: 750R; C_0402_1005Metric
R102, R103: 47k; C_0402_1005Metric
R104, R105, R108, R109: 10k; C_0402_1005Metric
R106: 100k; C_0402_1005Metric
R107: 2.2M; C_0402_1005Metric
R113: 4k7; C_0402_1005Metric
R114: R; C_0402_1005Metric
U1: LMV324; SOIC-14_3.9x8.7mm_P1.27mm
U102: AD8226ARMZ; MSOP-8_3x3mm_P0.65mm
U103: AP2210K-3.3; SOT-23-5
U104: MCP41010; SOIC-8_3.9x4.9mm_P1.27mm
U105: STM32F072CBTx; LQFP-48_7x7mm_P0.5mm

Connections:
+3.3VA: C102.1, C104.1, C108.1, C110.1, C115.1, C116.1, C127.1, C128.1, L101.2, R104.1, U1.4, U102.8, U105.9
+3V3: C112.1, C117.1, C119.1, C121.1, C123.1, C124.1, C125.1, L101.1, U103.5, U104.8, U105.1, U105.24, U105.36, U105.48
/MCP_CS: U104.1, U105.38
/MOSI: U104.3, U105.41
/SCK: U104.2, U105.39
/SIGNAL_N: J2.1, R103.2
/SIGNAL_P: J1.1, R102.2
/USB_DM: J101.2, U105.32
/USB_DP: J101.3, U105.33
/VADC: C120.1, R114.1, U105.11
/VREF_DAC: U1.12, U105.15, U105.16
GND: C102.2, C103.2, C104.2, C107.2, C108.2, C109.2, C110.2, C111.2, C112.2, C115.2, C116.2, C117.2, C118.2, C119.2, C120.2, C121.2, C122.2, C123.2, C124.2, C125.2, C126.2, C127.2, C128.2, J3.1, J101.5, J101.6, R105.2, R109.2, U1.11, U102.5, U103.2, U104.4, U105.8, U105.23, U105.35, U105.47
unnamed: C103.1, J101.1, L102.1
unnamed: C107.1, C109.1, C111.1, L102.2, U103.1, U103.3
unnamed: C114.1, R107.1, R108.2, U1.7
unnamed: C114.2, R106.1, R107.2, U1.6
unnamed: C118.1, U105.7
unnamed: C122.1, R104.2, R105.1, U1.3
unnamed: C126.1, U103.4
unnamed: R101.1, U102.2
unnamed: R101.2, U102.3
unnamed: R102.1, U102.1
unnamed: R103.1, U102.4
unnamed: R106.2, U102.7
unnamed: R108.1, R113.2, U1.9
unnamed: R109.1, U105.44
unnamed: R113.1, U104.7
unnamed: R114.2, U1.8, U104.5, U104.6
unnamed: U1.1, U1.2, U1.5, U1.10
unnamed: U1.13, U1.14, U102.6
