mhollands/EOGee/EOGee2/EOGee.kicad_pcb

## KiCad design EOGee2/EOGee.kicad_pcb (2020-04-15)

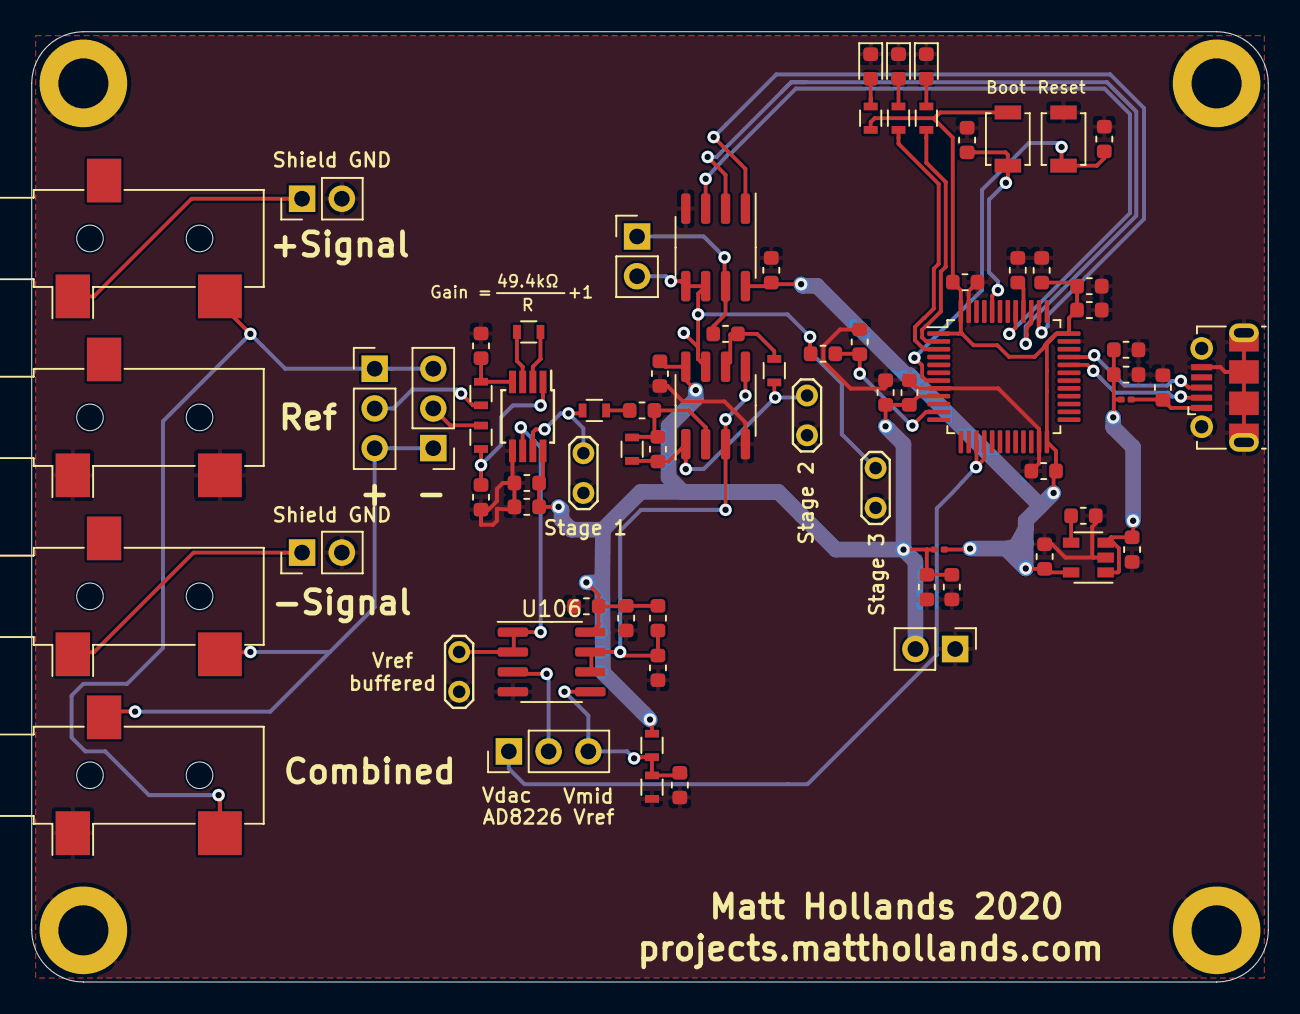
[picture p43: board EOGee2/EOGee.kicad_pcb from above]

Board: 2 copper layers, 79.0 x 60.7 mm, 78 parts (0 on the bottom side), 42 nets.

Parts:
C101, C102, C107, C108, C117, C118, C121, C123, C124, C127: 100nF; C_0603_1608Metric
C103, C115: 10nF; C_0603_1608Metric
C104, C109, C119, C125: 4.7uF; C_0603_1608Metric
C105, C106, C110, C113: 10uF; C_0603_1608Metric
C111, C116, C122, C128: 1uF; C_0603_1608Metric
C112: 2.2uF; C_0603_1608Metric
C114: 560pF; C_0603_1608Metric
C120: C; C_0603_1608Metric
C126: 100pF; C_0603_1608Metric
D101, D102, D103: LED; LED_0603_1608Metric
H101, H102, H103, H104: MountingHole_Pad; MountingHole_3.2mm_M3_DIN965_Pad
J101: USB_B_Micro; USB_Micro-B_Molex-105017-0001
J102: AudioJack3; Jack_3.5mm_CUI_SJ-3523-SMT_Horizontal
J103, J104, J105: AudioJack2; Jack_3.5mm_CUI_SJ-3523-SMT_Horizontal
J106: Conn_01x02; PinHeader_1x02_P2.54mm_Vertical
JP101, JP102: Jumper_NC_Small; PinHeader_1x02_P2.54mm_Vertical
JP103, JP104, JP105: Jumper_3_Bridged12; PinHeader_1x03_P2.54mm_Vertical
JP106: Jumper_NO_Small; PinHeader_1x02_P2.54mm_Vertical
L101, L102: BK0603HS330-T; L_0201_0603Metric
R101: 16k; R_0603
R102, R103: 47k; R_0603
R104, R105, R106, R108: 10k; R_0603
R107: 2.2M; R_0603
R109, R115: 10k; R_0603_1608Metric
R110, R111, R112: 750; R_0603
R113: 4k7; R_0603_1608Metric
R114, R116, R117: R; R_0603_1608Metric
SW101, SW102: SW_Push_45deg; SW_SPST_B3U-1000P
TP101, TP102, TP103, TP104: TestPoint_2Pole; TestPoint_2Pads_Pitch2.54mm_Drill0.8mm
U101, U106: LMV358; SOIC-8_3.9x4.9mm_P1.27mm
U102: AD8226ARMZ; MSOP-8_3x3mm_P0.65mm
U103: AP2210K-3.3; SOT-23-5
U104: MCP41010; SOIC-8_3.9x4.9mm_P1.27mm
U105: STM32F072CBTx; LQFP-48_7x7mm_P0.5mm

Connections:
+3.3VA: C101.1, C102.1, C104.1, C105.1, C108.1, C110.1, C115.1, C116.1, C127.1, C128.1, J106.2, L101.2, R104.1, U101.8, U102.8, U105.9, U106.8
+3V3: C112.1, C117.1, C119.1, C121.1, C123.1, C124.1, C125.1, L101.1, R112.1, SW101.1, U103.5, U104.8, U105.1, U105.24, U105.36, U105.48
/MCP_CS: U104.1, U105.38
/MISO: R115.1, U105.40
/MOSI: U104.3, U105.41
/SCK: U104.2, U105.39
/SIGNAL_N: J102.R, J104.T, JP103.1, JP104.3
/SIGNAL_P: J102.T, J103.T, JP103.3, JP104.1
/USB_DM: J101.2, U105.32
/USB_DP: J101.3, U105.33
/VADC: C120.1, R114.1, U105.11
/VREF_DAC: JP105.1, U105.15, U105.16
GND: C101.2, C102.2, C103.2, C104.2, C106.2, C107.2, C108.2, C109.2, C110.2, C111.2, C112.2, C115.2, C116.2, C117.2, C118.2, C119.2, C120.2, C121.2, C122.2, C123.2, C124.2, C125.2, C126.2, C127.2, C128.2, D101.1, D102.1, D103.1, H101.1, H102.1, H103.1, H104.1, J101.5, J101.6, J102.S, J105.S, J105.T, J106.1, JP101.2, JP102.2, R105.2, R109.2, R115.2, R116.1, R117.2, SW102.1, TP101.2, TP102.2, TP103.2, TP104.2, U101.4, U102.5, U103.2, U104.4, U105.8, U105.23, U105.35, U105.47, U106.4
unnamed: C103.1, J101.1, L102.1
unnamed: C105.2, C106.1, U101.3, U101.5, U106.6, U106.7
unnamed: C107.1, C109.1, C111.1, L102.2, U103.1, U103.3
unnamed: C113.1, C114.2, R107.2, U101.2
unnamed: C113.2, R106.1
unnamed: C114.1, R107.1, R108.2, TP102.1, U101.1
unnamed: C118.1, SW102.2, U105.7
unnamed: C122.1, JP105.3, R104.2, R105.1, U106.5
unnamed: C126.1, U103.4
unnamed: D101.2, R110.2
unnamed: D102.2, R111.2
unnamed: D103.2, R112.2
unnamed: J103.S, JP101.1
unnamed: J104.S, JP102.1
unnamed: JP103.2, R102.2
unnamed: JP104.2, R103.2
unnamed: JP105.2, U106.3
unnamed: JP106.1, R113.1, U104.7
unnamed: JP106.2, R114.2, TP103.1, U101.7, U104.5, U104.6
unnamed: R101.1, U102.2
unnamed: R101.2, U102.3
unnamed: R102.1, R116.2, U102.1
unnamed: R103.1, R117.1, U102.4
unnamed: R106.2, TP101.1, U102.7
unnamed: R108.1, R113.2, U101.6
unnamed: R109.1, SW101.2, U105.44
unnamed: R110.1, U105.3
unnamed: R111.1, U105.2
unnamed: TP104.1, U102.6, U106.1, U106.2
