mhollands/EOGee/SigGenAdapter/PCB/SigGenAdapter/SigGenAdapter.kicad_pcb

## KiCad design SigGenAdapter/PCB/SigGenAdapter/SigGenAdapter.kicad_pcb (2020-03-22)

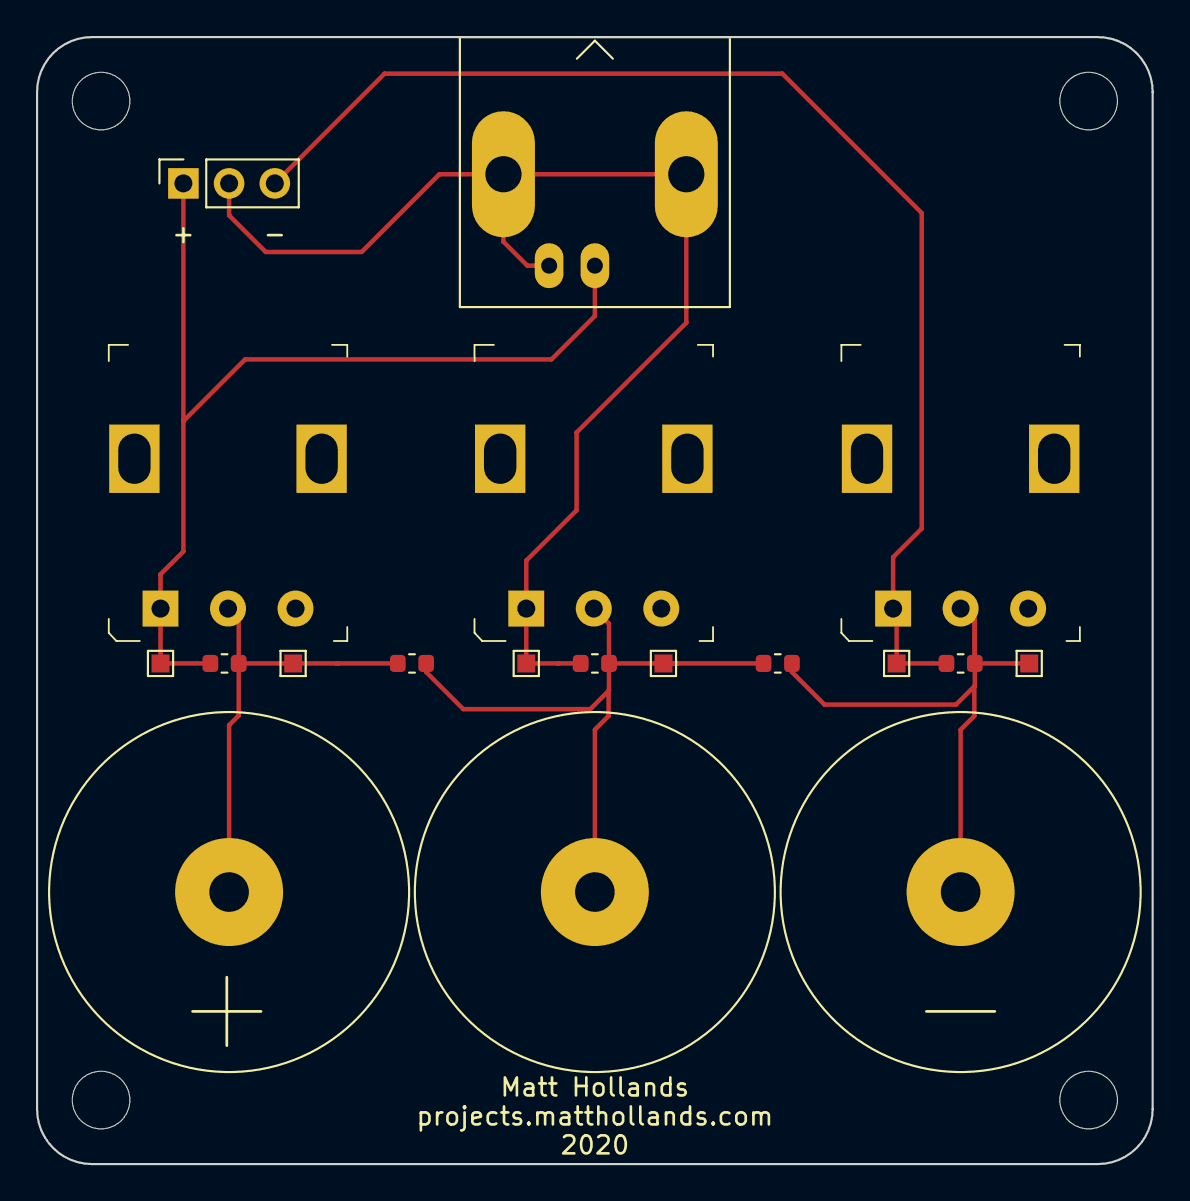
[picture p44: board SigGenAdapter.kicad_pcb from above]

Board: 2 copper layers, 62.0 x 62.6 mm, 23 parts (0 on the bottom side), 6 nets.

Parts:
H1, H2, H3, H4: MountingHole; MountingHole_3.2mm_M3
J1: Conn_Coaxial; BNC_Amphenol_B6252HB-NPP3G-50_Horizontal
J2: Conn_01x03; PinSocket_1x03_P2.54mm_Vertical
J3, J4, J5: Screw_Terminal_01x01; MountingHole_2.2mm_M2_Pad
R1, R2, R3, R4, R5: R; R_0603_1608Metric
RV1, RV2, RV3: R_POT; Potentiometer_P120PK-Y25BR10K
TP1, TP2, TP3, TP4, TP5, TP6: TestPoint; TestPoint_Pad_1.0x1.0mm

Connections:
/GND: J1.2, J2.2, R3.2, RV3.1, TP1.1
/GND_R: J4.1, R3.1, R4.1, R5.2, RV3.2, TP2.1
/SIGNAL_N: J2.3, R2.2, RV2.1, TP4.1
/SIGNAL_N_R: J5.1, R2.1, R5.1, RV2.2, TP6.1
/SIGNAL_P: J1.1, J2.1, R1.2, RV1.1, TP3.1
/SIGNAL_P_R: J3.1, R1.1, R4.2, RV1.2, TP5.1
