mhollands/EOGee/EOGee1/EOGee.kicad_pcb

## KiCad design EOGee1/EOGee.kicad_pcb (2020-01-20, an earlier design)

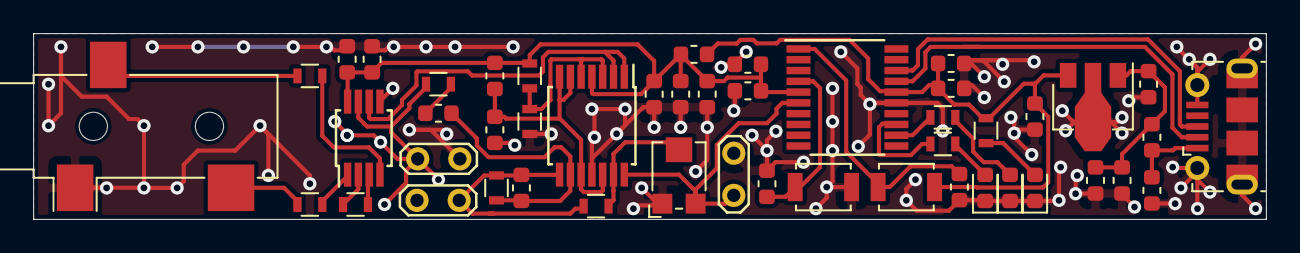
[picture p45: board EOGee1/EOGee.kicad_pcb from above]

Board: 2 copper layers, 74.3 x 11.2 mm, 48 parts (0 on the bottom side), 29 nets.

Parts:
C101, C108: 0.1uF; C_0603_1608Metric
C102, C107, C117, C118: 100nF; C_0603_1608Metric
C103, C115: 10nF; C_0603_1608Metric
C104, C109, C119: 4.7uF; C_0603_1608Metric
C105, C106, C110, C113: 10uF; C_0603_1608Metric
C111, C112, C116: 1uF; C_0603_1608Metric
C114: 560pF; C_0603_1608Metric
D101, D102, D103: LED; LED_0603_1608Metric
J101: USB_B_Micro; USB_Micro-B_Molex-105017-0001
J102: AudioJack3; Jack_3.5mm_CUI_SJ-3523-SMT_Horizontal
L101, L102: BK0603HS330-T; L_0603_1608Metric
R101: 16k; R_0603
R102, R103: 47k; R_0603
R104, R105, R106: 10k; R_0603
R107: 2.2M; R_0603
R108: 1k; R_0603
R109: 10k; R_0603_1608Metric
R110, R111, R112: 750; R_0603
RV101: R_POT; Potentiometer_Bourns_TC33X_Vertical
SW101, SW102: SW_Push_45deg; SW_SPST_B3U-1000P
TP101, TP102, TP103: TestPoint_2Pole; TestPoint_2Pads_Pitch2.54mm_Drill0.8mm
U101: LMV324; TSSOP-14_4.4x5mm_P0.65mm
U102: AD8226ARMZ; MSOP-8_3x3mm_P0.65mm
U103: AP2210; SOT-89-3
U105: STM32F042F4Px; TSSOP-20_4.4x6.5mm_P0.65mm

Connections:
+3.3VA: C101.1, C102.1, C104.1, C105.1, C108.1, C110.1, C115.1, C116.1, L101.2, R104.1, U101.4, U102.8, U105.5
+3V3: C112.1, C117.1, C119.1, L101.1, R112.1, SW101.1, U103.3, U105.16
/USB_DM: J101.2, U105.17
/USB_DP: J101.3, U105.18
GND: C101.2, C102.2, C103.2, C104.2, C106.2, C107.2, C108.2, C109.2, C110.2, C111.2, C112.2, C115.2, C116.2, C117.2, C118.2, C119.2, D101.1, D102.1, D103.1, J101.5, J101.6, J102.S, R105.2, R109.2, RV101.1, SW102.1, TP101.2, TP102.2, TP103.2, U101.11, U102.5, U103.2, U105.15
unnamed: C103.1, J101.1, L102.1
unnamed: C105.2, C106.1, U101.6, U101.7, U101.10, U101.12
unnamed: C107.1, C109.1, C111.1, L102.2, U103.1
unnamed: C113.1, C114.2, R107.2, U101.9
unnamed: C113.2, R106.1
unnamed: C114.1, R107.1, R108.2, TP102.1, U101.8
unnamed: C118.1, SW102.2, U105.4
unnamed: D101.2, R110.2
unnamed: D102.2, R111.2
unnamed: D103.2, R112.2
unnamed: J102.R, R103.2
unnamed: J102.T, R102.2
unnamed: R101.1, U102.2
unnamed: R101.2, U102.3
unnamed: R102.1, U102.1
unnamed: R103.1, U102.4
unnamed: R104.2, R105.1, U101.3, U101.5
unnamed: R106.2, TP101.1, U102.7
unnamed: R108.1, RV101.2, U101.13
unnamed: R109.1, SW101.2, U105.1
unnamed: R110.1, U105.13
unnamed: R111.1, U105.12
unnamed: RV101.3, TP103.1, U101.14, U105.6
unnamed: U101.1, U101.2, U102.6
