mhollands/EOGee/EOGee2/STM32/Core/Src/main.c

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

/* Includes ------------------------------------------------------------------*/
#include "main.h"
#include "usb_device.h"

/* USER CODE BEGIN Includes */
#include "usbd_cdc_if.h"
/* USER CODE END Includes */

/* USER CODE BEGIN PD */
#define ADC_TARGET 2048
#define ADC_TARGET_RANGE 10
#define ADC_CORRECTION_RANGE 1500
/* USER CODE END PD */

ADC_HandleTypeDef hadc;

DAC_HandleTypeDef hdac;
DMA_HandleTypeDef hdma_dac_ch1;
DMA_HandleTypeDef hdma_dac_ch2;

SPI_HandleTypeDef hspi1;

TIM_HandleTypeDef htim1;
TIM_HandleTypeDef htim2;

/* USER CODE BEGIN PV */
#define BUFFER_LEN 10
uint16_t buffer[BUFFER_LEN*2];
volatile uint8_t buffer_pointer;
volatile int correcting = 0;
volatile uint16_t dac_code = 0;
uint16_t electrode_sense_waveform[100] = {2048, 2176, 2304, 2431, 2557, 2680, 2801, 2919, 3034, 3145, 3251, 3353, 3449, 3540, 3625, 3704, 3776, 3842, 3900, 3951, 3995, 4031, 4059, 4079, 4091, 4095, 4091, 4079, 4059, 4031, 3995, 3951, 3900, 3842, 3776, 3704, 3625, 3540, 3449, 3353, 3251, 3145, 3034, 2919, 2801, 2680, 2557, 2431, 2304, 2176, 2048, 1920, 1792, 1665, 1539, 1416, 1295, 1177, 1062, 951, 845, 743, 647, 556, 471, 392, 320, 254, 196, 145, 101, 65, 37, 17, 5, 1, 5, 17, 37, 65, 101, 145, 196, 254, 320, 392, 471, 556, 647, 743, 845, 951, 1062, 1177, 1295, 1416, 1539, 1665, 1792, 1920};
/* USER CODE END PV */

void SystemClock_Config(void);
static void MX_GPIO_Init(void);
static void MX_DMA_Init(void);
static void MX_DAC_Init(void);
static void MX_SPI1_Init(void);
static void MX_ADC_Init(void);
static void MX_TIM1_Init(void);
static void MX_TIM2_Init(void);
/* USER CODE BEGIN PFP */
HAL_StatusTypeDef Set_MCP41010_Resistance(uint8_t resistance);
/* USER CODE END PFP */

/**
  * @brief  The application entry point.
  * @retval int
  */
int main(void)
{
  /* MCU Configuration--------------------------------------------------------*/

  /* Reset of all peripherals, Initializes the Flash interface and the Systick. */
  HAL_Init();

  /* Configure the system clock */
  SystemClock_Config();

  /* Initialize all configured peripherals */
  MX_GPIO_Init();

  MX_DMA_Init();
  MX_DAC_Init();
  MX_USB_DEVICE_Init();
  MX_SPI1_Init();
  MX_ADC_Init();
  MX_TIM1_Init();
  MX_TIM2_Init();
  /* USER CODE BEGIN 2 */
  HAL_Delay(3000);
  //CDC_Transmit_FS((uint8_t*)"Hello\n\r", 7);
  /* USER CODE END 2 */



  /* Infinite loop */
  /* USER CODE BEGIN WHILE */

  uint64_t sum = 0;
  while(1)
  {
	  HAL_GPIO_WritePin(LED1_GPIO_Port, LED1_Pin, GPIO_PIN_SET);
	  sum = 0;
	  for(int i = 0; i < 20; i++)
	  {
		  sum += electrode_sense_waveform[i]*electrode_sense_waveform[i];
	  }
	  sum = sum*sum;
	  HAL_GPIO_WritePin(LED1_GPIO_Port, LED1_Pin, GPIO_PIN_RESET);
	  HAL_Delay(500);
  }

  HAL_Delay(1000);
  Set_MCP41010_Resistance(255);

  // Start feedback DAC
  dac_code = ADC_TARGET;
  HAL_DAC_Start_DMA(&hdac, DAC_CHANNEL_2, (uint32_t *) &dac_code, 1, DAC_ALIGN_12B_R);
  correcting = 1;

  // Start electrode sense dac
  HAL_DAC_Start_DMA(&hdac, DAC_CHANNEL_1, (uint32_t *) electrode_sense_waveform, 100, DAC_ALIGN_12B_R);

  // Start EOG ADC conversions
  buffer_pointer = 0;
  HAL_ADC_Start_IT(&hadc);

  // Start timer 2 which triggers electrode sense DAC  and feedback DAC
  HAL_TIM_OC_Start_IT(&htim2,TIM_CHANNEL_1);

  // Start timer 1 which triggers EOG ADC
  HAL_TIM_OC_Start_IT(&htim1,TIM_CHANNEL_1);

  while (1)
  {
    /* USER CODE END WHILE */

    /* USER CODE BEGIN 3 */
	  if(buffer_pointer == BUFFER_LEN)
	  {
		  // Toggle LED
		  HAL_GPIO_TogglePin(LED1_GPIO_Port, LED1_Pin);
		  // Send data buffer over usb
		  CDC_Transmit_FS((void*)buffer, 2*2*BUFFER_LEN);
		  // Reset data buffer
		  buffer_pointer = 0;
	  }
  }
  /* USER CODE END 3 */
}

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
/* USER CODE BEGIN 4 */

HAL_StatusTypeDef Set_MCP41010_Resistance(uint8_t resistance)
{
	uint8_t data[2];
	data[1] = 0x11;
	data[0] = resistance;
	return HAL_SPI_Transmit(&hspi1, (void *) &data, 1, HAL_MAX_DELAY);
}

/* USER CODE BEGIN 4 */
/**
  * @brief  Conversion complete callback in non blocking mode
  * @param  hadc ADC handle
  * @retval None
  */
void HAL_ADC_ConvCpltCallback(ADC_HandleTypeDef* hadc)
{
	uint32_t sample = HAL_ADC_GetValue(hadc);

	// Put data in buffer
	if(buffer_pointer < BUFFER_LEN)
	{
		buffer[buffer_pointer] = (0x8000 | (uint16_t) sample);
		buffer[buffer_pointer+BUFFER_LEN] = (0x4000 | dac_code);
		buffer_pointer++;
	}
	else
	{
		// If no space in buffer, turn on LED as warning
		HAL_GPIO_WritePin(LED2_GPIO_Port, LED2_Pin, GPIO_PIN_SET);
	}

	// Adjust DAC to move ADC towards target
	if(correcting == 1)
	{
		if(sample > ADC_TARGET+ADC_TARGET_RANGE)
		{
			if(dac_code > 0)
			{
				dac_code -= 1;
			}
		}
		else if(sample < ADC_TARGET-ADC_TARGET_RANGE)
		{
			if(dac_code < 4095)
			{
				dac_code += 1;
			}
		}
		else
		{
			correcting = 0;
		}
	}
	else
	{
		if(sample > ADC_TARGET + ADC_CORRECTION_RANGE || sample < ADC_TARGET-ADC_CORRECTION_RANGE)
		{
			correcting = 1;
		}
	}
}

/* USER CODE END 4 */
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
