mhollands/EOGee/EOGee2/STM32/EOGee2.ioc

Mcu.UserName=STM32F072CBTx
PA1.Signal=ADC_IN1
PA11.Signal=USB_DM
PA12.Signal=USB_DP
PA15.Signal=SPI1_NSS
PA4.Signal=COMP_DAC1_group
PA5.Signal=COMP_DAC2_group
PB3.Signal=SPI1_SCK
PB5.Signal=SPI1_MOSI
PC13.GPIO_Label=LED1
PC13.Signal=GPIO_Output
PC14-OSC32_IN.GPIO_Label=LED2
PC14-OSC32_IN.Signal=GPIO_Output
