mhollands/EOGee/EOGee1/STM32/EOGeeold/Inc/main.h

#define LED1_Pin GPIO_PIN_6
#define LED1_GPIO_Port GPIOA
#define LED2_Pin GPIO_PIN_7
#define LED2_GPIO_Port GPIOA
