mhollands/EOGee/EOGee1/Python/f_behrens_et_al.py

# This script streams data from EOGee1 and implements the saccade detection algorithm described in the paper
# "An improved algorithm for automatic detection of saccades in eye movement data and for calculating saccade parameters"
# by F. Behrens et al.

import serial
import numpy as np
import matplotlib.pyplot as plt
from matplotlib.animation import FuncAnimation
import time
from typing import NamedTuple

def onClick(event):
    global pause
    pause ^= True

def get_data(s):
	global playback_ptr
	timestamp = None
	data = []
	# If we are streaming data over serial
	if(type(s) == serial.Serial):
		timestamp = (time.time(), len(ydata))
		num_bytes_available = int(np.floor(s.in_waiting/2.0)*2)
		points_8bit = s.read(num_bytes_available)
		points_16bit = [points_8bit[i+1] * 256 + points_8bit[i] for i in range(0,len(points_8bit), 2)]
		data = points_16bit
	# IF we are playing back from a file
	if(type(s) == np.ndarray):
		timestamp = (time.time(), len(ydata))
		data = s[playback_ptr:playback_ptr+playback_step]
		playback_ptr += playback_step
		if(playback_ptr > len(s)):
			playback_ptr = 0
	return [timestamp, data]

def update(frame, s):
	global ydata
	global pause

	if(pause):
		return

	# Get data from source
	[timestamp, data] = get_data(s)
	# Get the latest processed data point
	y_ptr = len(ydata)
	dy_ptr = len(dydata)
	d2y_ptr = len(d2ydata)

	# Save new data
	timestamps.append(timestamp)

	# Get latest processed sample
	t_latest = len(ydata)

	# Add new ydata
	ydata.extend(data)

	# For each new sample, update dy
	while(len(dydata) < len(ydata)):
		if(len(dydata) == 0):
			dydata.append(0)
		else:
			dydata.append(ydata[len(dydata)] - ydata[len(dydata)-1])

	# For each new sample, update dy
	while(len(d2ydata) < len(ydata) - 1):
		# If this is the first sample we can't calculate d2y or NSigma or MSF or F1 or Fmon or F2 or F3 so put 0
		if(len(d2ydata) == 0):
			d2ydata.append(0)
			NSigmadata.append(0)
			MSFdata.append(0)
			F1data.append(0)
			Fmondata.append(0)
			F2data.append(0)
			F3data.append(0)
			continue

		# Calculate d2y
		d2ydata.append(ydata[len(d2ydata)+1] - 2*ydata[len(d2ydata)] + ydata[len(d2ydata)-1])
		# If we are before the acceleration window, we cannot calculate NSigma so we cannot calculate MSF, put 0
		if(len(d2ydata) < acceleration_window):
			NSigmadata.append(0)
			MSFdata.append(0)
			F1data.append(0)
			Fmondata.append(0)
			F2data.append(0)
			F3data.append(0)
			continue
		# Calcualte NSigma as N times the std of the previous samples in accerleation window
		NSigmadata.append(N*np.std(d2ydata[-acceleration_window:]))

		# If the saccade is complete, reset all flags
		if(F3data[-1] == 1 and Fmondata[-1] == 1):
			MSFdata.append(0)
			F1data.append(0)
			Fmondata.append(0)
			F2data.append(0)
			F3data.append(0)
			continue

		# If MSF is 0 and d2y crossed the NSigma threshold, set MSF to 1 or -1
		if(MSFdata[-1] == 0 and np.abs(d2ydata[-1]) > np.abs(NSigmadata[-1])):
			MSFdata.append(np.sign(d2ydata[-1]))
		else:
			# By default MSF should retain state
			MSFdata.append(MSFdata[-1])
		# If we are in a saccade and F1 crosses NSigma line
		if(MSFdata[-1] != 0 and F1data[-1] == 0 and np.sign(MSFdata[-1])*d2ydata[-1] < NSigmadata[-1]):
			F1data.append(1)
		else:
			F1data.append(F1data[-1])
		# At least one cycle after F1 is set, set Fmon if the sign of dy changes (end of monotonicity)
		if(Fmondata[-1] == 0 and F1data[-1] == 1 and F1data[-2] == 1 and np.sign(dydata[len(Fmondata)]) != np.sign(dydata[len(Fmondata)-1])):
			Fmondata.append(1)
		else:
			Fmondata.append(Fmondata[-1])
		# After F1 is set, when we cross the opposite NSigma line, set F2
		if(MSFdata[-1] != 0 and F1data[-1] != 0 and F2data[-1] == 0 and np.sign(MSFdata[-1])*d2ydata[-1] < -NSigmadata[-1]):
			F2data.append(1)
		else:
			F2data.append(F2data[-1])
		# After F1 is set adn F2, when we cross the opposite NSigma line again, set F3
		if(MSFdata[-1] != 0 and F1data[-1] != 0 and F2data[-1] != 0 and F3data[-1] == 0 and np.sign(MSFdata[-1])*d2ydata[-1] > -NSigmadata[-1]):
			F3data.append(1)
		else:
			F3data.append(F3data[-1])

	# Select the end samples
	y = ydata[-buffer_len:]
	dy = dydata[-buffer_len:]
	d2y = d2ydata[-buffer_len:]
	NSigma = NSigmadata[-buffer_len:]
	MSF = MSFdata[-buffer_len:]
	F1 = F1data[-buffer_len:]
	Fmon = Fmondata[-buffer_len:]
	F2 = F2data[-buffer_len:]
	F3 = F3data[-buffer_len:]

	ty = range(len(ydata)-buffer_len, len(ydata))
	tdy = np.array(range(len(dydata)-buffer_len, len(dydata)))-0.5 #The time of each dy sample is actually 0.5 samples behind y
	td2y = range(len(d2ydata)-buffer_len, len(d2ydata))
	tNSigma = range(len(NSigmadata)-buffer_len, len(NSigmadata))
	tMSF = range(len(MSFdata)-buffer_len, len(MSFdata))
	tF1 = range(len(F1data)-buffer_len, len(F1data))
	tFmon = range(len(Fmondata)-buffer_len, len(Fmondata))
	tF2 = range(len(F2data)-buffer_len, len(F2data))
	tF3 = range(len(F3data)-buffer_len, len(F3data))

	# Make sure we have enough samples to plot y data
	if(len(y) < len(ty)):
		print("Waiting for y-buffer to fill, {0}/{1}".format(len(y), len(ty)))
		return

	yheadroom = 0
	dyheadroom = 10
	# Update position plot
	ln_y.set_data(ty, y)
	ax_y.set_ylim(np.min(y)-yheadroom, np.max(y)+yheadroom)
	ax_y.set_xlim(np.min(ty), np.max(ty))

	# Make sure we have enough samples to plot dy data
	if(len(dy) < len(tdy)):
		print("Waiting for dy-buffer to fill, {0}/{1}".format(len(dy), len(tdy)))
		return

	# Update velocity plot
	ln_dy.set_data(tdy, dy)
	ax_dy.set_ylim(np.min(dy)-dyheadroom, np.max(dy)+dyheadroom)
	ax_dy.set_xlim(np.min(tdy), np.max(tdy))	

	# Make sure we have enough samples to plot dy data
	if(len(d2y) < len(td2y)):
		print("Waiting for d2y-buffer to fill, {0}/{1}".format(len(d2y), len(td2y)))
		return
	
	# Update acceleration plot
	ln_d2y.set_data(td2y, d2y)
	ylim = [np.min([-2*np.max(NSigma), np.min(d2y)]),np.max([2*np.max(NSigma), np.max(d2y)])]
	# ylim = [np.min([0, np.min(d2y)]),np.max([0, np.max(d2y)])]
	ax_d2y.set_ylim(ylim)
	ax_d2y.set_xlim(np.min(td2y), np.max(td2y))

	# Make sure we have enough samples to plot NSigma data
	if(len(NSigma) < len(tNSigma)):
		print("Waiting for NSigma-buffer to fill, {0}/{1}".format(len(NSigma), len(tNSigma)))
		return
	ln_nsigma_p.set_data(tNSigma, NSigma)
	ln_nsigma_n.set_data(tNSigma, -np.array(NSigma))
	
	# Make sure we have enough samples to plot MSF data
	if(len(MSF) < len(tMSF)):
		print("Waiting for MSF-buffer to fill, {0}/{1}".format(len(MSF), len(tMSF)))
		return
	ln_MSF.set_data(tMSF, MSF)
	ln_F1.set_data(tF1, F1)
	ln_Fmon.set_data(tFmon, Fmon)
	ln_F2.set_data(tF2, F2)
	ln_F3.set_data(tF3, F3)
	ax_Flags.set_xlim(np.min(tMSF), np.max(tMSF))	
	return

buffer_len = 2000
acceleration_window = 200
sampling_rate = 48000000/65336
N = 3.4
playback = False
playback_file = "fake_saccade_slow.npy"
playback_step = 100

timestamps = []
fig, ax = plt.subplots(4,1, sharex=True)
ydata = []
dydata = []
d2ydata = []
NSigmadata = []
MSFdata = []
F1data = []
Fmondata = []
F2data = []
F3data = []
pause = 0

if(not playback):
	# s = serial.Serial("/dev/tty.usbmodem2050316A41501")
	s = serial.Serial("/dev/tty.usbmodem2073358838301")
else:
	s = np.load(playback_file)
	playback_ptr = 0
	ydata = list(np.ones(buffer_len+acceleration_window)*s[playback_ptr])
	dydata = list(np.zeros(buffer_len+acceleration_window))
	d2ydata = list(np.zeros(buffer_len+acceleration_window))
	NSigmadata = list(np.zeros(buffer_len+acceleration_window))
	MSFdata = list(np.zeros(buffer_len+acceleration_window))
	F1data = list(np.zeros(buffer_len+acceleration_window))
	Fmondata = list(np.zeros(buffer_len+acceleration_window))
	F2data = list(np.zeros(buffer_len+acceleration_window))
	F3data = list(np.zeros(buffer_len+acceleration_window))

ax_y = ax[0]
ln_y, = ax_y.plot([], [], 'r-')
ax_y.set_xlabel("Sample")
ax_y.set_ylabel("Voltage / V")

ax_dy = ax[1]
ln_dy, = ax_dy.plot([], [], 'r-')
ax_dy.set_xlabel("Sample")
ax_dy.set_ylabel("dV/dt / Vs^-1")

ax_d2y = ax[2]
ln_d2y, = ax_d2y.plot([], [], 'r-')
ln_nsigma_p, = ax_d2y.plot([], [], 'b--')
ln_nsigma_n, = ax_d2y.plot([], [], 'b--')
ax_d2y.set_xlabel("Sample")
ax_d2y.set_ylabel("dV2/d2yt / Vs^-2")

ax_Flags = ax[3]
ln_MSF, = ax_Flags.plot([], [], 'r-', label="MSF")
ln_F1, = ax_Flags.plot([], [], 'r--', label="F1")
ln_Fmon, = ax_Flags.plot([], [], 'b-', label="Fmon")
ln_F2, = ax_Flags.plot([], [], 'b--', label="F2")
ln_F3, = ax_Flags.plot([], [], 'g-', label="F3")
ax_Flags.legend()
ax_Flags.set_xlabel("Sample")
ax_Flags.set_ylabel("Flags")
ax_Flags.set_ylim(-1.5,1.5)

# Setup on click event
fig.canvas.mpl_connect('button_press_event', onClick)

ani = FuncAnimation(fig, update, fargs=[s])
plt.show()
