mhollands/EOGee/EOGee2/Python/viewer.py

import serial
import numpy as np
import matplotlib.pyplot as plt
from matplotlib.animation import FuncAnimation
import scipy.signal
import scipy.stats
import time
import glob

buffer_len = 2000
sampling_rate = 48000000/65336
adc_per_dac = 22;

def connect_to_usb():
	available_devices = []
	print("Looking for usb device...")
	while(len(available_devices) < 1):
		available_devices = glob.glob("/dev/tty.usbmodem*")
	print("Connecting to {0}".format(available_devices[0]))
	s = serial.Serial(available_devices[0])
	return s

def plot_filter(b,a,fs):
	freq, h = scipy.signal.freqz(b, a, fs=fs)
	# Plot
	fig, ax = plt.subplots(2, 1, figsize=(8, 6))
	ax[0].plot(freq, 20*np.log10(abs(h)), color='blue')
	ax[0].set_title("Frequency Response")
	ax[0].set_ylabel("Amplitude (dB)", color='blue')
	ax[0].grid()
	ax[1].plot(freq, np.unwrap(np.angle(h))*180/np.pi, color='green')
	ax[1].set_ylabel("Angle (degrees)", color='green')
	ax[1].set_xlabel("Frequency (Hz)")
	ax[1].grid()
	plt.show()
	return

def init():
    return

def update(frame):
	global ydata
	global fdata
	global s

	try:
		num_bytes_available = int(np.floor(s.in_waiting/2.0)*2)
		points_8bit = s.read(num_bytes_available)
	except:
  		print("Unable to communicate with device...")
  		s = connect_to_usb()
  		return


	points_16bit = [points_8bit[i+1] * 256 + points_8bit[i] for i in range(0,len(points_8bit), 2)]

	[ydata.append(x & 0x0FFF) for x in points_16bit if (x >> 12) == 0x8]
	[dacdata.append(x & 0x0FFF) for x in points_16bit if (x >> 12) == 0x4]

	y = ydata - (np.array(dacdata) - 2048)*adc_per_dac
	# y = np.convolve(y, np.ones(26)/26, mode="valid")
	y_filt = scipy.signal.lfilter(filt_b, filt_a, y)

	d = dacdata[-buffer_len:]

	y = y[-buffer_len:]
	y_filt = y_filt[-buffer_len:]

	ax_t.set_ylim(np.min(y), np.max(y))
	ax_t.set_xlim(0, len(y))
	ln_t.set_data(range(len(y)), y)
	ln_tf.set_data(range(len(y_filt)), y_filt)

	# ddd = np.diff(np.diff(d))
	# # [ax_d.lines[i].remove() for i in range(1,len(ax_d.lines))]
	# ax_d.lines.clear()
	# for i in range(1,len(ddd)):
	# 	if(ddd[i] != 0):
	# 		ax_d.axvline(i)
	ax_d.set_ylim(0, 4096)
	ax_d.set_xlim(0, len(d))
	ln_d.set_data(range(len(d)), d)
	# ax_d.plot(range(len(d)), d, c='red')

	# Take fourier transform of data with mean value removed
	fdata = np.abs(np.fft.fft(y - np.mean(y)))
	fdata_filt = np.abs(np.fft.fft(y_filt - np.mean(y_filt)))
	freqs = np.arange(0,int(len(fdata)/2)) * sampling_rate / len(fdata)
	ax_f.set_ylim(np.min([fdata, fdata_filt]), np.max([fdata, fdata_filt]))
	ax_f.set_xlim(0, np.max(freqs))
	ln_f.set_data(freqs, fdata[0:int(len(fdata)/2)])
	ln_ff.set_data(freqs, fdata_filt[0:int(len(fdata)/2)])
	return

s = connect_to_usb()

filt_b, filt_a = scipy.signal.iirnotch(60, 3, fs=sampling_rate)
# plot_filter(filt_b, filt_a, sampling_rate)

fig, [ax_t, ax_d, ax_f] = plt.subplots(3,1)
ydata = []
dacdata = []
fdata = []
ln_t, = ax_t.plot([], [], 'r-')
ln_tf, = ax_t.plot([], [], 'b-')
ln_d, = ax_d.plot([], [], 'r-')
ln_f, = ax_f.plot([], [], 'r-')
ln_ff, = ax_f.plot([], [], 'b-')

ax_t.set_xlabel("Sample")
ax_t.set_ylabel("ADC Code")

ax_d.set_xlabel("Sample")
ax_d.set_ylabel("DAC Code")

ax_f.set_xlabel("Frequency /Hz")
ax_f.set_ylabel("Power")

ani = FuncAnimation(fig, update, init_func=init)
plt.show()

noise_range = ydata[1000: min(45000, len(ydata))]
mean = np.mean(noise_range)
std = np.std(noise_range)
pk = np.max(noise_range)
tr = np.min(noise_range)
print("Mean: {0}".format(mean))
print("Range: {0}-{1} = {2} over {3} samples".format(pk, tr, pk-tr, len(noise_range)))
print("Std: {0}".format(std))
biggest_spike = np.max([pk-mean, mean-tr])
pdf = scipy.stats.norm(0, std).cdf(-biggest_spike)
print("Biggest spike: {0}".format(biggest_spike))
print("Probability of this spike or worse: {0}".format(pdf))

ydata_filt = volts_filt = scipy.signal.lfilter(filt_b, filt_a, ydata)
noise_range_filt = ydata_filt[1000: min(45000, len(ydata))]
mean = np.mean(noise_range_filt)
std = np.std(noise_range_filt)
pk = np.max(noise_range_filt)
tr = np.min(noise_range_filt)
print("")
print("Filtered Mean: {0}".format(mean))
print("Filtered Range: {0}-{1} = {2} over {3} samples".format(pk, tr, pk-tr, len(noise_range_filt)))
print("Filtered Std: {0}".format(std))
biggest_spike = np.max([pk-mean, mean-tr])
pdf = scipy.stats.norm(0, std).cdf(-biggest_spike)
print("Filtered Biggest spike: {0}".format(biggest_spike))
print("Filtered Probability of this spike or worse: {0}".format(pdf))

if(len(ydata) > 0):
	save_data = {"ydata": ydata, "dacdata": dacdata}
	filename = "logger_data_{0}.npy".format(str(time.time()).replace(".", "-"))
	np.save(filename, save_data)
	print("Saved as {0}".format(filename))
