mhollands/EOGee/(commit log)

2020-01-20 add initial schematic
2020-02-18 moved to STM32MXCubeIDE
2020-02-18 add name to schematic:
    [EOGee.sch]
2020-02-19 add ADC and timer
2020-02-19 Timer approximately 10hz, start ADC. ADC complete copy into buffer. buffer full send via serial.
2020-02-19 turn on green LED if no space in buffer at any point
2020-02-19 sample around 70hz
2020-02-19 (i mean 700hz). Python viewer now converts 8 bit data into 16 bit data and displays it. Limit to 1000 samples on screen
2020-02-23 fix bug where bytes were in the wrong order
    [viewer.py]
2020-02-24 plot in volts and samples. Do fourier transform. Do 60hz notch filter
2020-02-24 add initial glasses model
    [Glasses_front.scad, Glasses_front.stl, Glasses_front_right.stl]
2020-02-26 move to new EOGee1 folder
    [EOGee-B_Cu.gbr, EOGee-B_Mask.gbr, EOGee-B_Paste.gbr, EOGee-B_SilkS.gbr, EOGee-Edge_Cuts.gbr, EOGee-F_Cu.gbr, EOGee-F_Mask.gbr, EOGee-F_Paste.gbr]
2020-02-26 moved everythign to EOGee1 folder
    [EOGee-B_Cu.gbr, EOGee-B_Mask.gbr, EOGee-B_Paste.gbr, EOGee-B_SilkS.gbr, EOGee-Edge_Cuts.gbr, EOGee-F_Cu.gbr, EOGee-F_Mask.gbr, EOGee-F_Paste.gbr]
2020-02-26 started work on active probe design
    [ActiveProbe.kicad_pcb, ActiveProbe.sch]
2020-02-27 added amplifier stages and filtering
    [ActiveProbe.sch]
2020-03-09 models, active probe, ltspice model
    [ActiveProbe.sch, Glasses_front.scad, Glasses_front.stl, Glasses_front_right.stl, Plastic_snap.scad, Plastic_snap.stl]
2020-03-22 Add siggen adapter files
    [Base.scad, Base.stl, Lid.scad, Lid.stl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]
2020-03-28 add circuit analysis for EOG1
2020-03-28 added 3d printed plastic snap models
    [Plastic_snap.scad, Plastic_snap.stl]
2020-03-28 add EOG2 kicad design
    [Base.scad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]
2020-04-03 rewrite f behrens with better support for per sample calculations in a way that doesn't hurt the brain
    [f_behrens_et_al.py]
2020-04-05 added F3 flag and reset flags when saccade complete
    [f_behrens_et_al.py]
2020-04-12 show noise stats at the end of viewer
    [Glasses_front.scad, Glasses_front.stl, Glasses_front_right.stl, Plastic_snap.scad, Plastic_snap.stl]
2020-04-12 add noise measurements from EOG1
    [BUS01.CSV, BUS02.CSV, BUS03.CSV, BUS04.CSV, BUS05.CSV, BUS06.CSV, BUS07.CSV, BUS08.CSV]
2020-04-12 tidying up
    [EOGee.kicad_pcb]
2020-04-12 add eog2 housing model and base model
    [Base.scad, Base.stl, Housing.scad, Housing.stl]
2020-04-14 add empty stm32 fw
2020-04-14 add example code for leds and DAC
2020-04-15 :add code to set MCP41010 resistance
2020-04-15 replace OP2177 with LMV358 because does not support 3.3V rail
    [EOGee.kicad_pcb, EOGee.sch]
2020-04-17 add code from EOGee1 to stream ADC over USB
2020-04-19 Center dac command is no longer needed
    [main.c]
2020-04-23 Insert correct resistor values for gains
    [EOGee.sch]
2020-05-25 everything up to date
    [Base_clip.scad, Base_clip.stl, clip.scad, clip.stl]
2020-05-25 add EOGee2 schematic
2020-06-01 add EOGlass1 files:
    [EOGlass v1.stl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]
2020-06-21 add PDF schematics for EOGlass1 and SigGenAdapter
2020-06-27 add sinewave dma to DAC_OUT2
2020-06-28 trigger EOG ADC conversion with timer1 automatically instead of calling from timer interrupt
2020-06-28 feedback DAC is now driven by DMA instead of software writes. This fixes bug where DAC channel 1 was set by software and DMA because its not possible for software to only set one DAC channel. Also di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
    [EOGee2.ioc, main.c]
2020-06-28 change electrode sense frequency to 1khz
2020-06-29 change stim frequency to 300Hz
